kayjayB/I_cant_hear_you/Final Report/gainGUIAudiogram.PDF

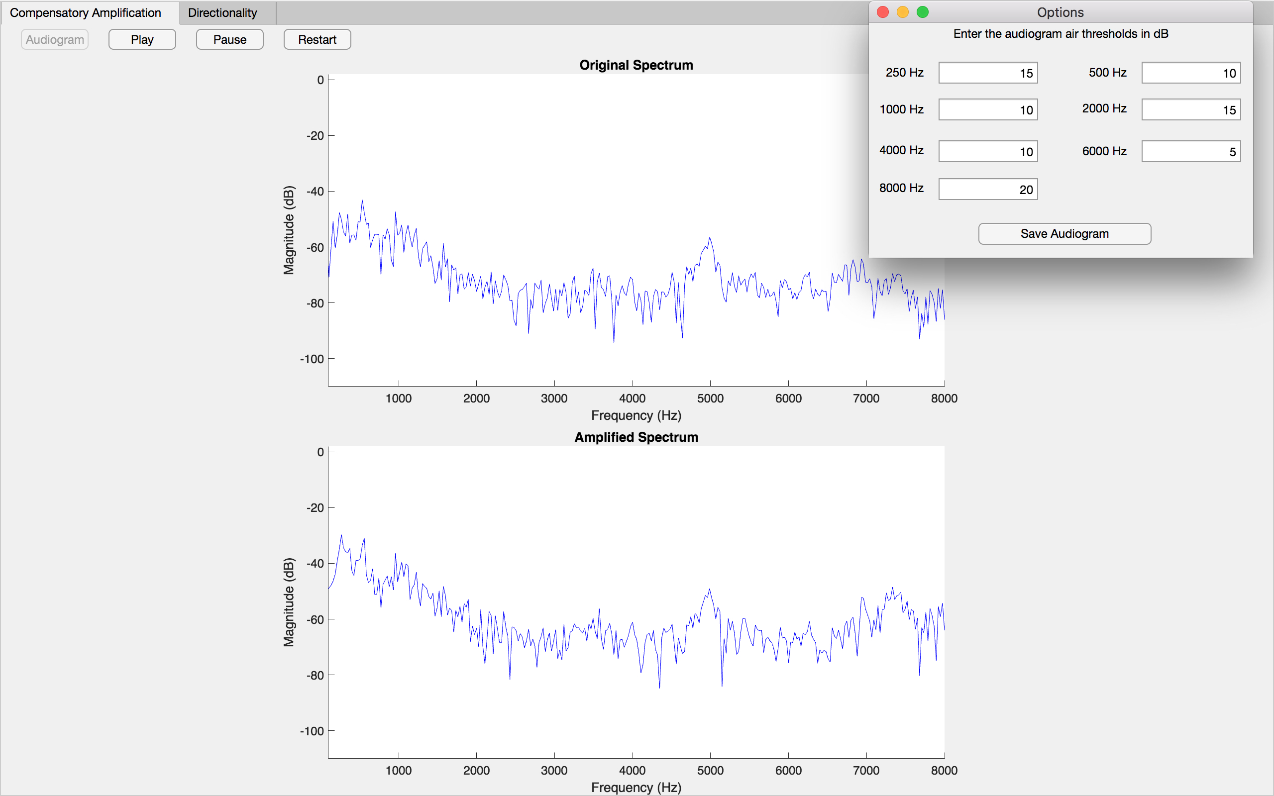
[picture p34: page 1]
