kayjayB/I_cant_hear_you/Final Report/dirGUI.PDF

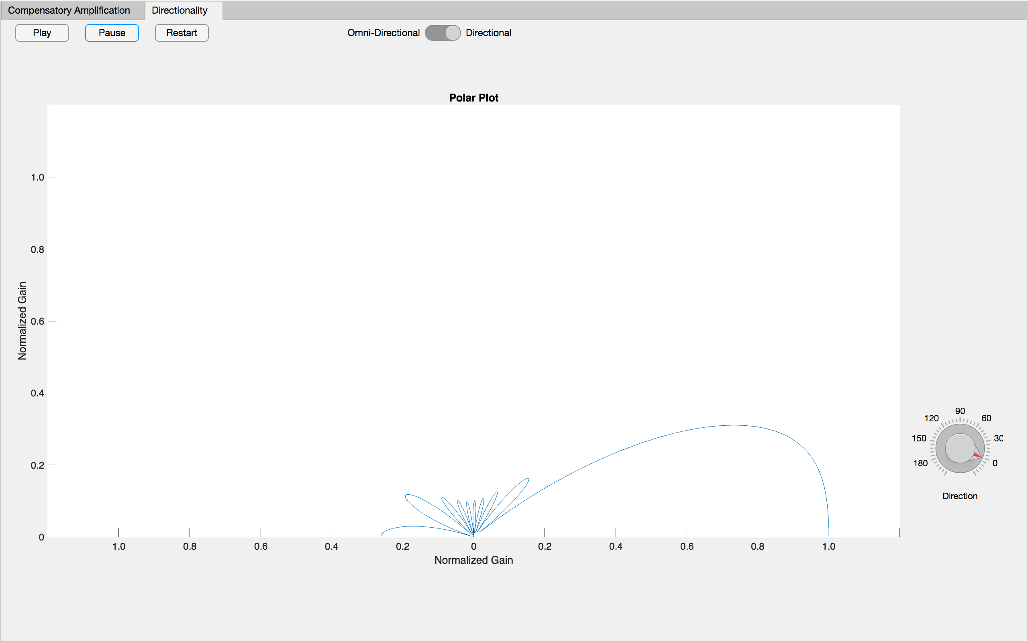
[picture p35: page 1]
