kayjayB/I_cant_hear_you/Final Report/dirGUISmall.PDF

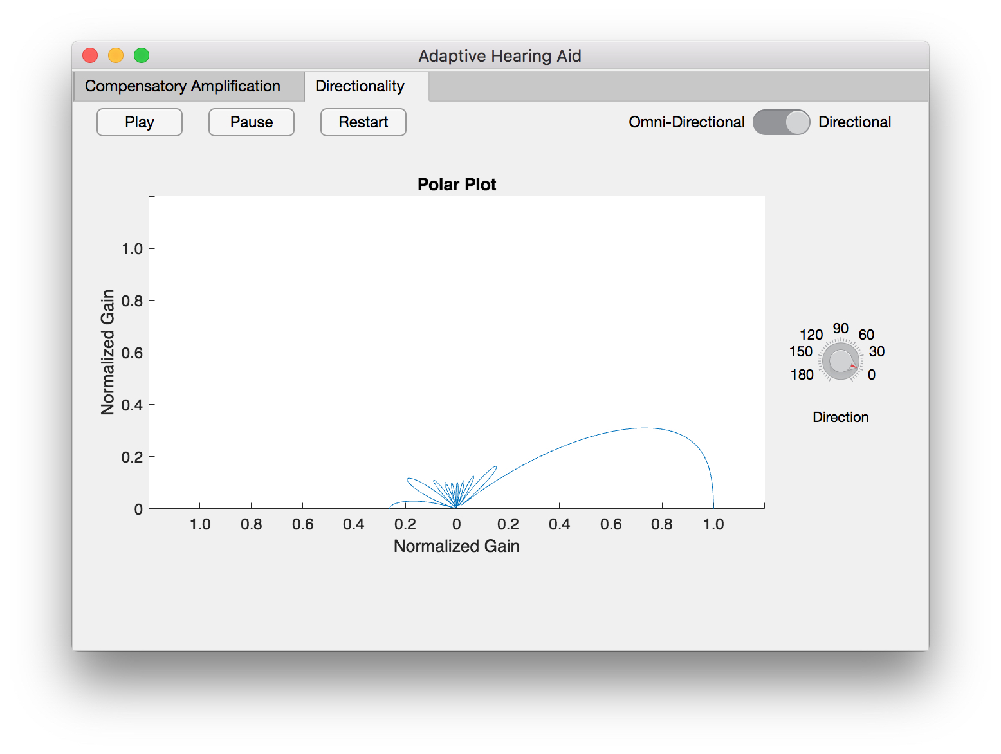
[picture p36: page 1]
