kayjayB/I_cant_hear_you/Final Report/gainGUI.PDF

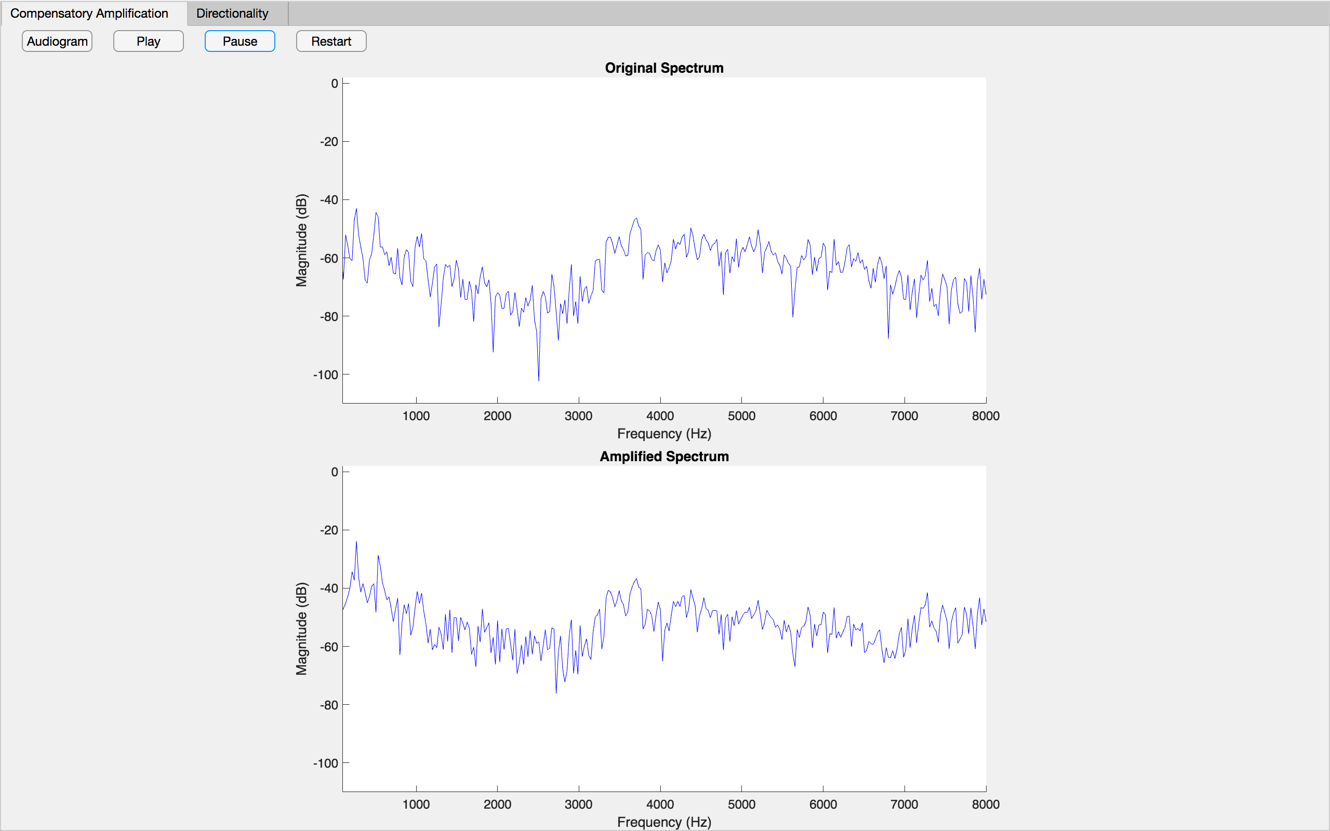
[picture p37: page 1]
