kayjayB/I_cant_hear_you/Final Report/gainGUISmall.PDF

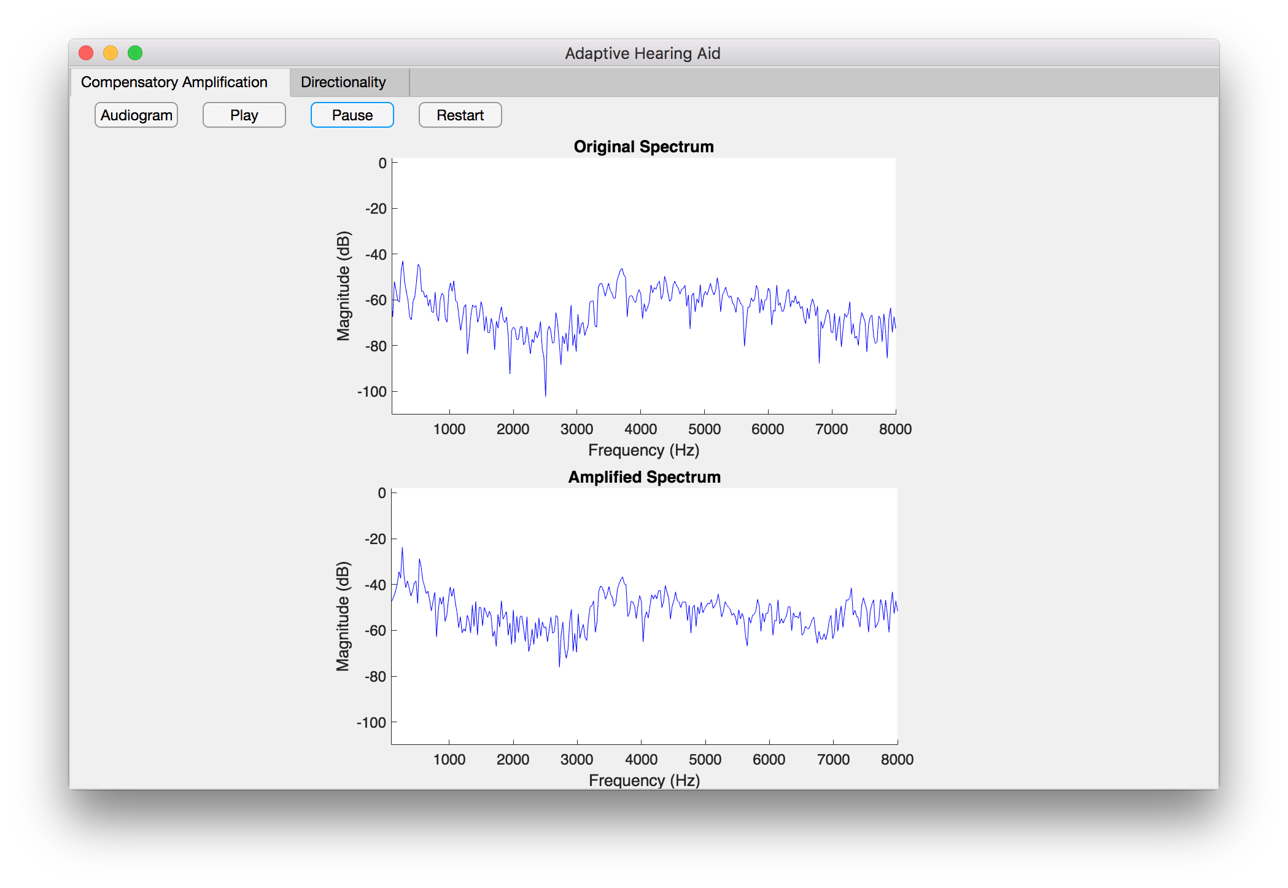
[picture p38: page 1]
