kayjayB/I_cant_hear_you/Poster/figures/EIE.pdf

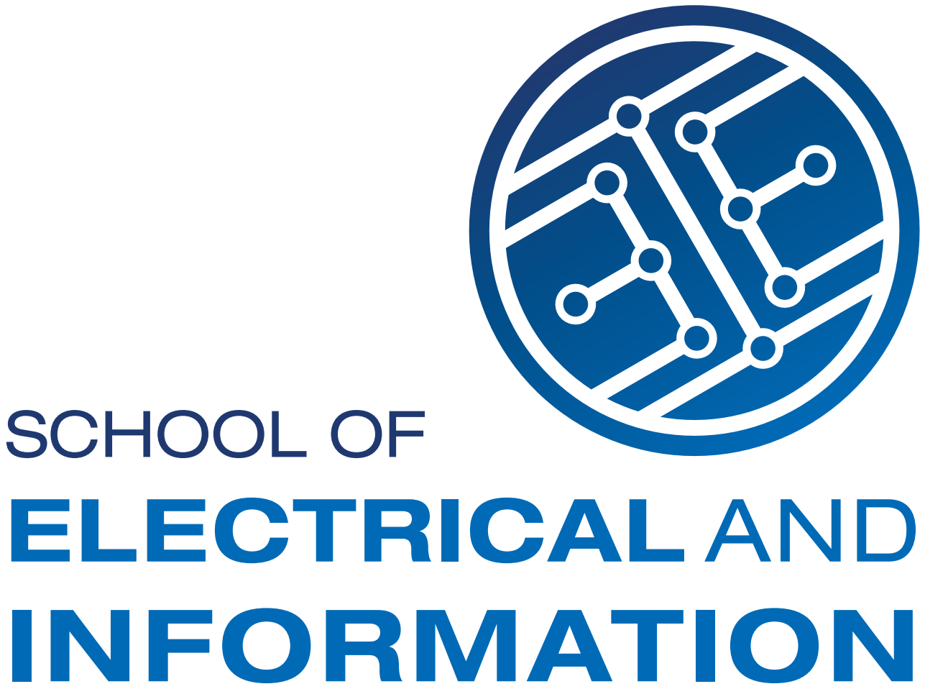
[picture p39: figure]
SCHOOL OF ELECTRICAL AND INFORMATION

ENGINEERING
