kayjayB/I_cant_hear_you/Final Report/analogFilterBank.png

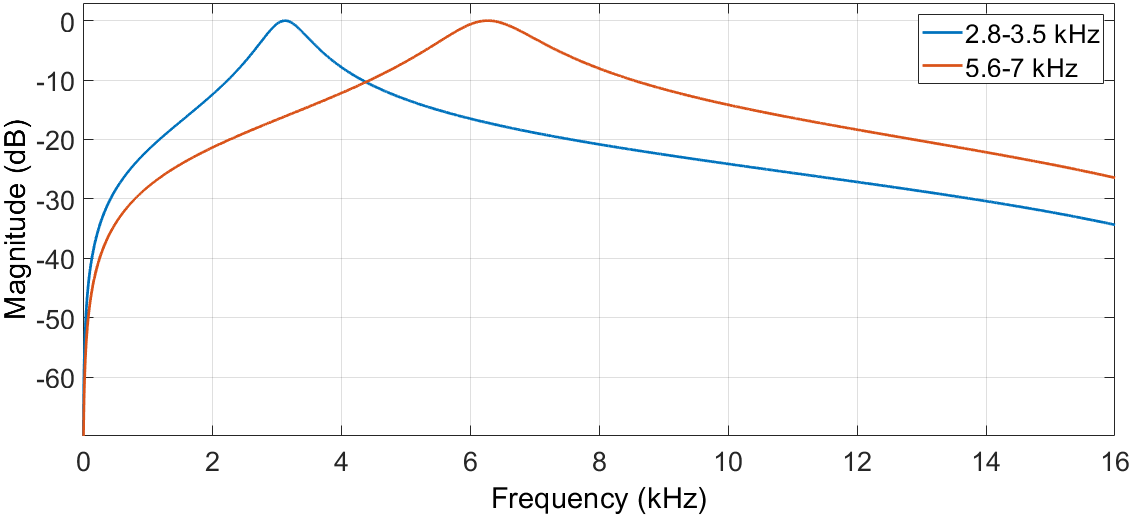
Final Report/analogFilterBank.png
