kayjayB/I_cant_hear_you/Final Report/audiogram.png

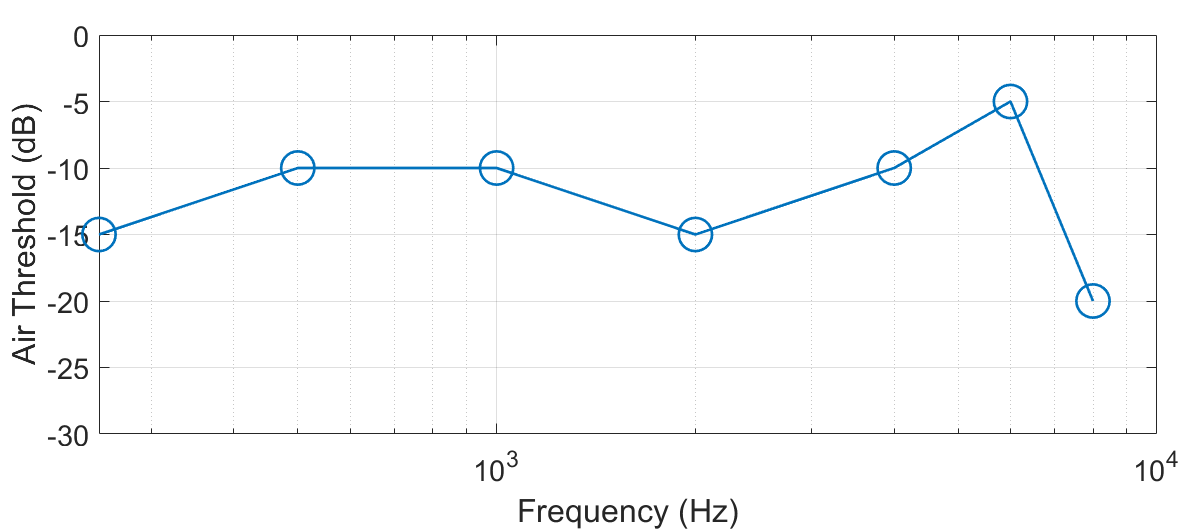
Final Report/audiogram.png
