kayjayB/I_cant_hear_you/Final Report/circuit3kband.png

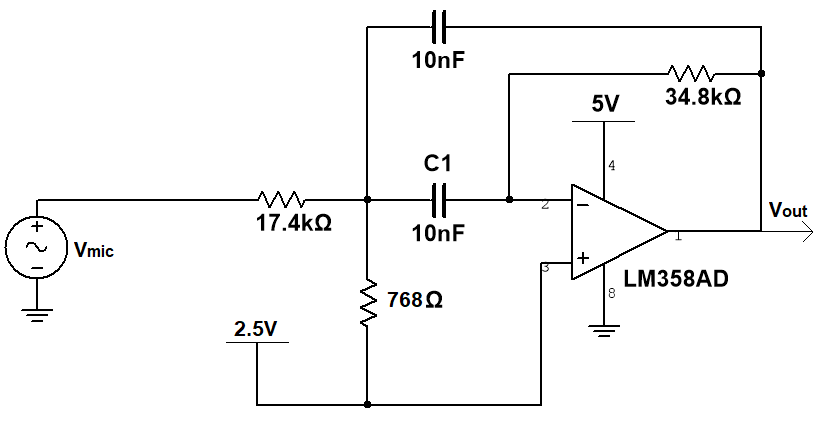
Final Report/circuit3kband.png
