kayjayB/I_cant_hear_you/Final Report/circuit6kband.png

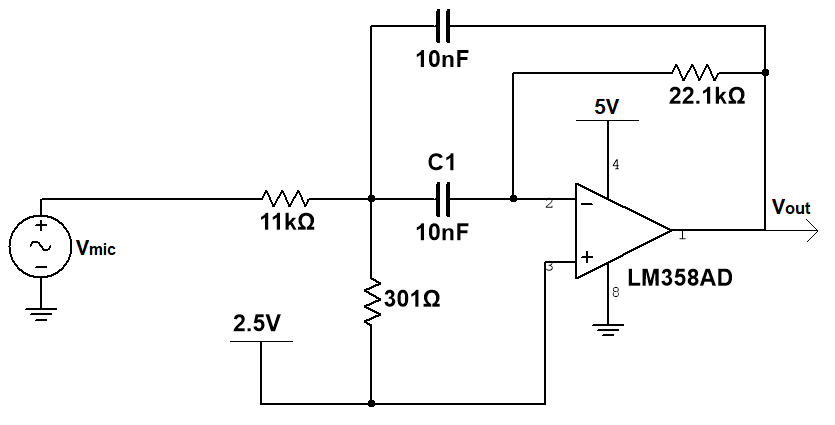
Final Report/circuit6kband.png
