kayjayB/I_cant_hear_you/Final Report/Dir0.png

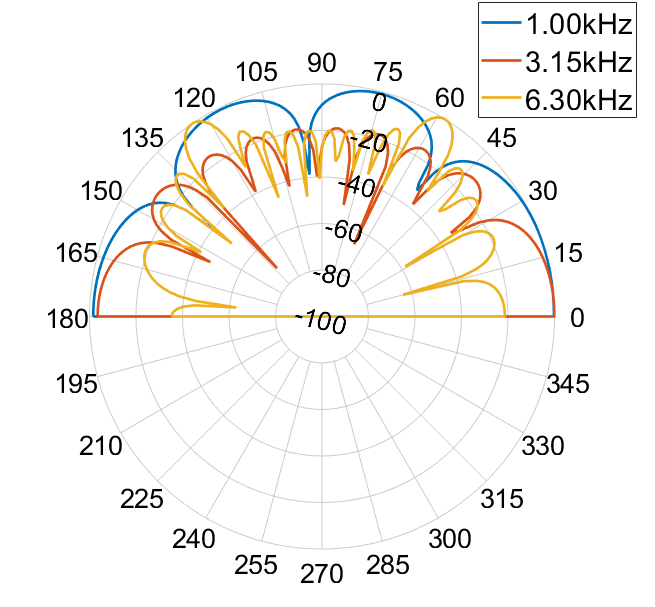
Final Report/Dir0.png
