kayjayB/I_cant_hear_you/Final Report/guiOmni.png

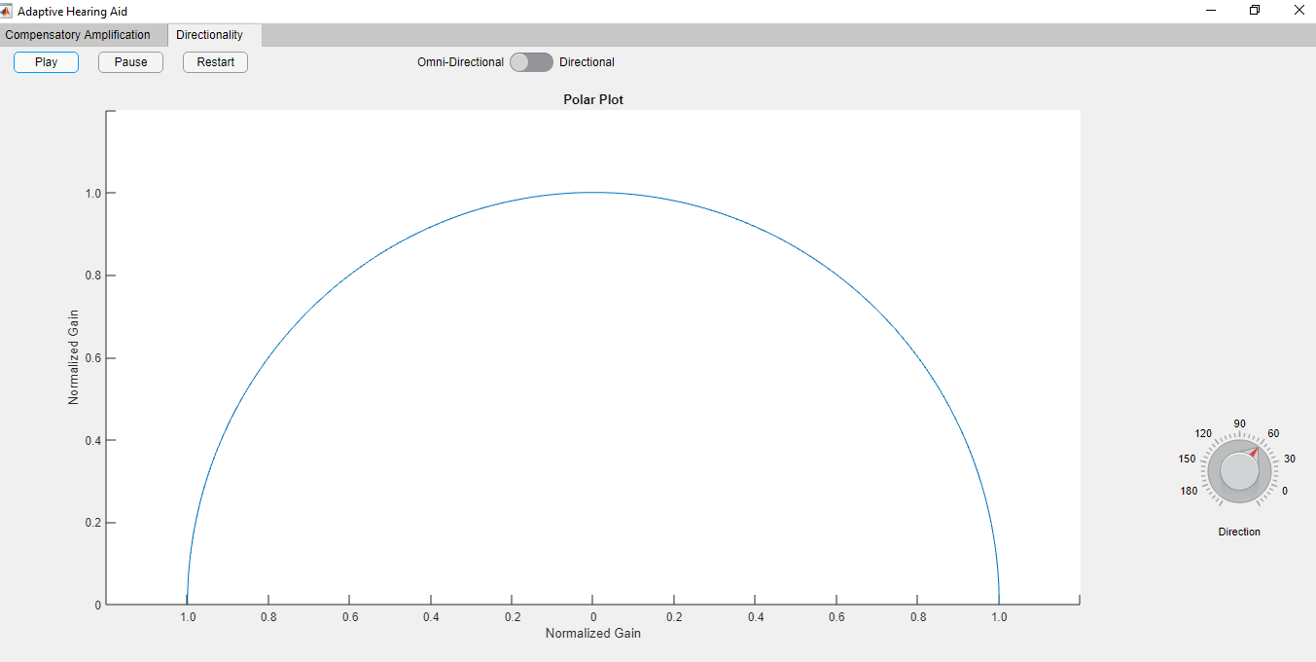
Final Report/guiOmni.png
