kayjayB/I_cant_hear_you/Final Report/guiPolar60.png

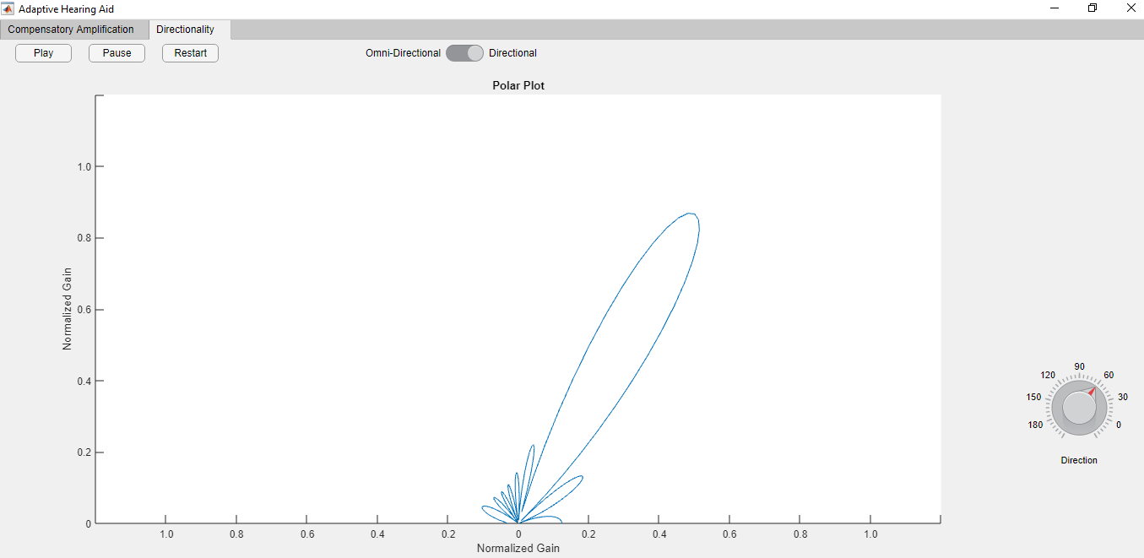
Final Report/guiPolar60.png
