kayjayB/I_cant_hear_you/Final Report/hardware0.png

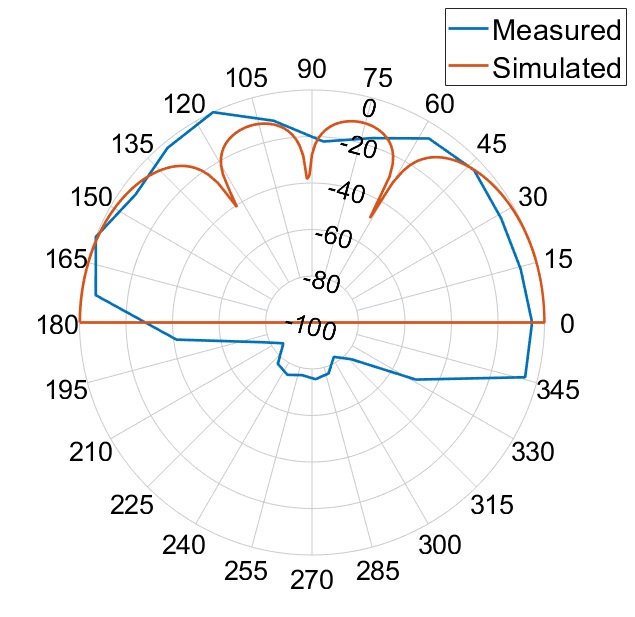
Final Report/hardware0.png
