kayjayB/I_cant_hear_you/Final Report/hardware120.png

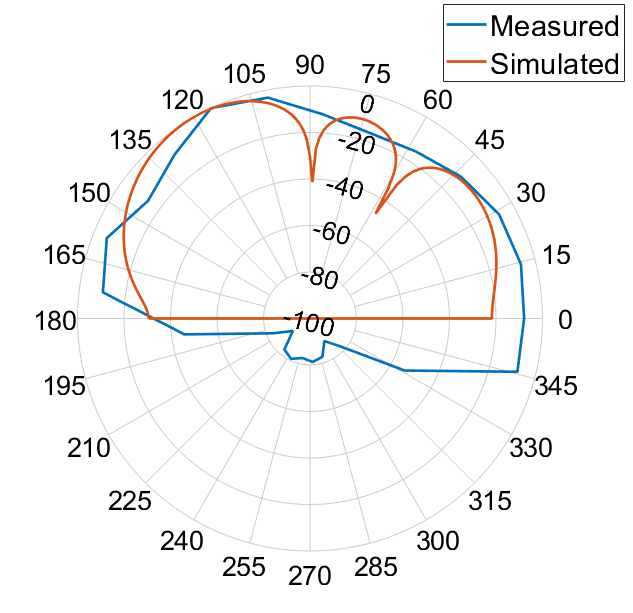
Final Report/hardware120.png
