kayjayB/I_cant_hear_you/Final Report/hardware180.png

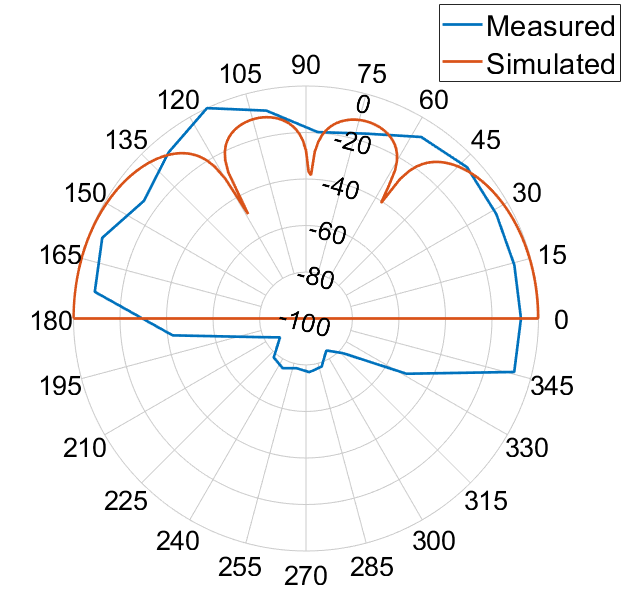
Final Report/hardware180.png
