kayjayB/I_cant_hear_you/Final Report/hardwareOmni.png

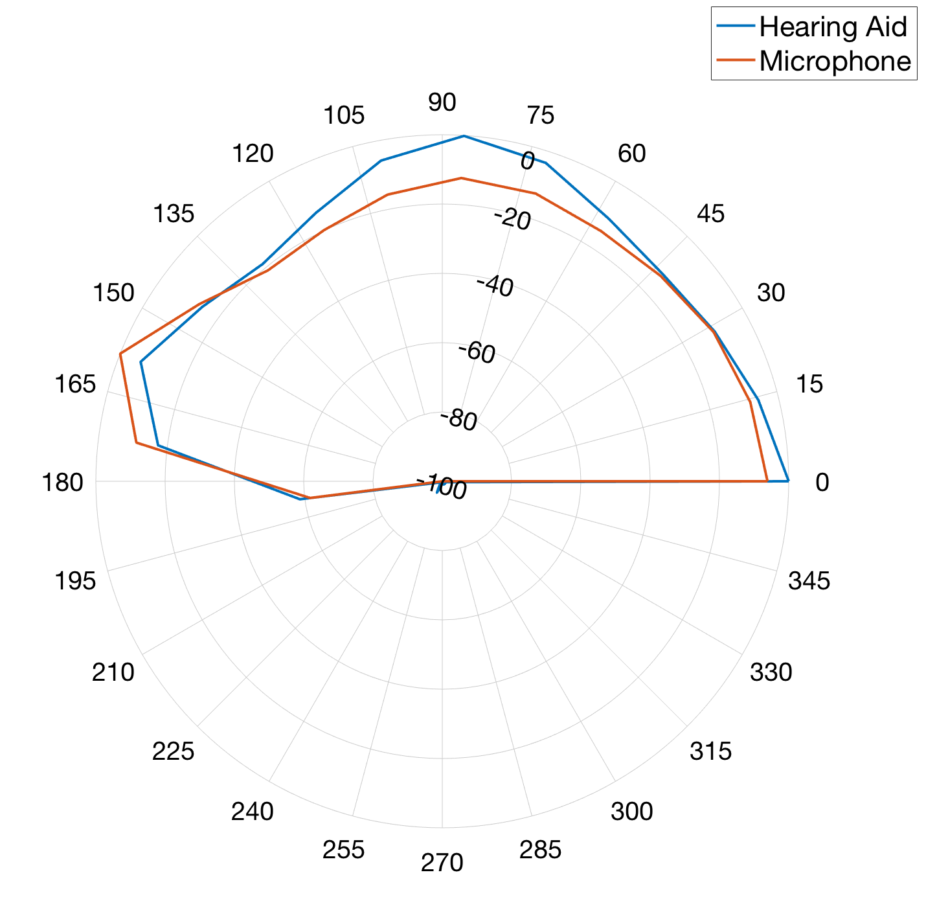
Final Report/hardwareOmni.png
