kayjayB/I_cant_hear_you/Final Report/posterBlockDiagram.png

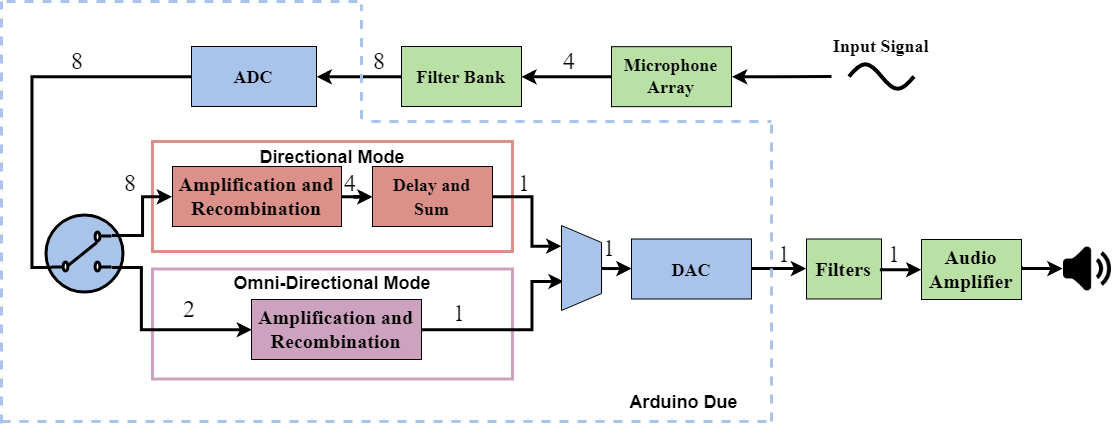
Final Report/posterBlockDiagram.png
