kayjayB/I_cant_hear_you/Memes/0ce60ced1e4ded8629fa3b05bb8c4171--hipster-humor-hipster-dog.jpg

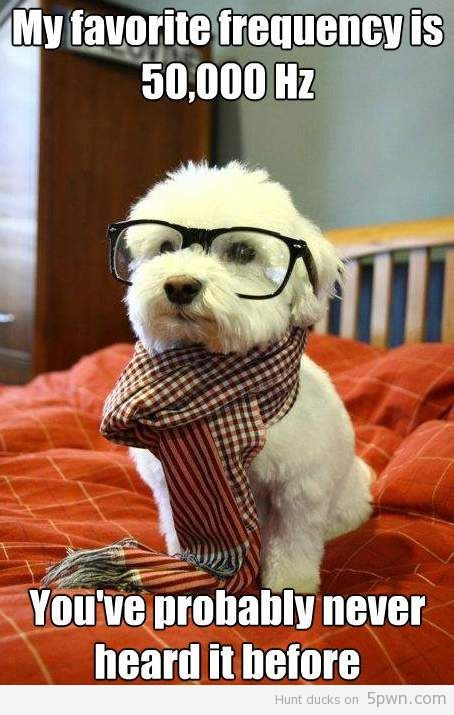
Memes/0ce60ced1e4ded8629fa3b05bb8c4171--hipster-humor-hipster-dog.jpg
