kayjayB/I_cant_hear_you/Memes/cat ignore.jpg

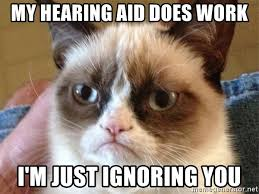
Memes/cat ignore.jpg
