kayjayB/I_cant_hear_you/Memes/pretend not to hear.jpg

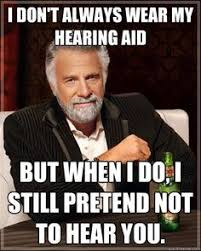
Memes/pretend not to hear.jpg
