kayjayB/I_cant_hear_you/Poster/figures/audiogram.png

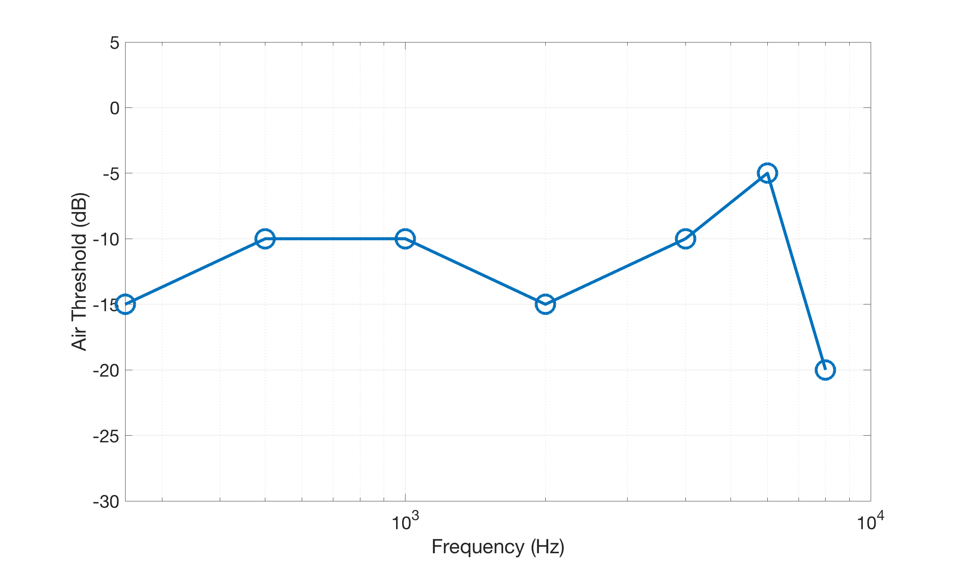
Poster/figures/audiogram.png
