kayjayB/I_cant_hear_you/Poster/figures/cartesian.png

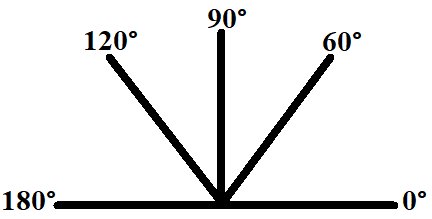
Poster/figures/cartesian.png
