kayjayB/I_cant_hear_you/Poster/figures/deg0hardware.png

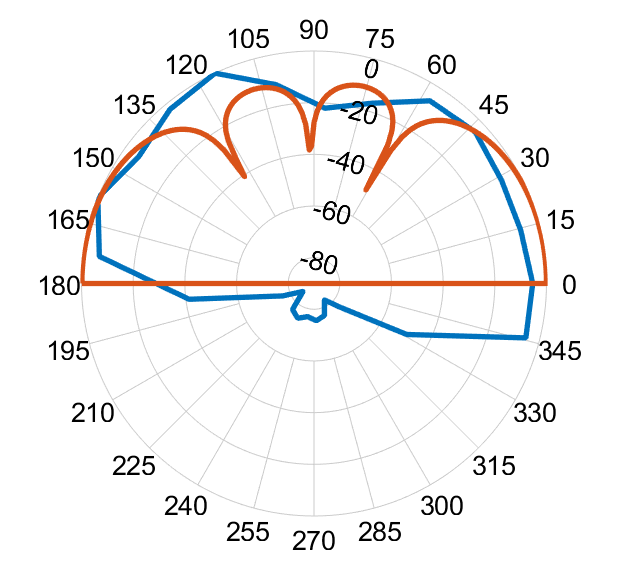
Poster/figures/deg0hardware.png
