kayjayB/I_cant_hear_you/Poster/figures/deg60hardware.png

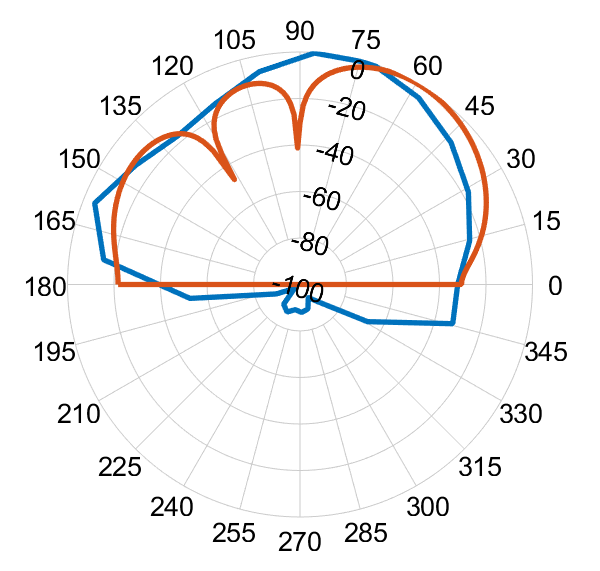
Poster/figures/deg60hardware.png
