kayjayB/I_cant_hear_you/Poster/figures/deg120hardware.png

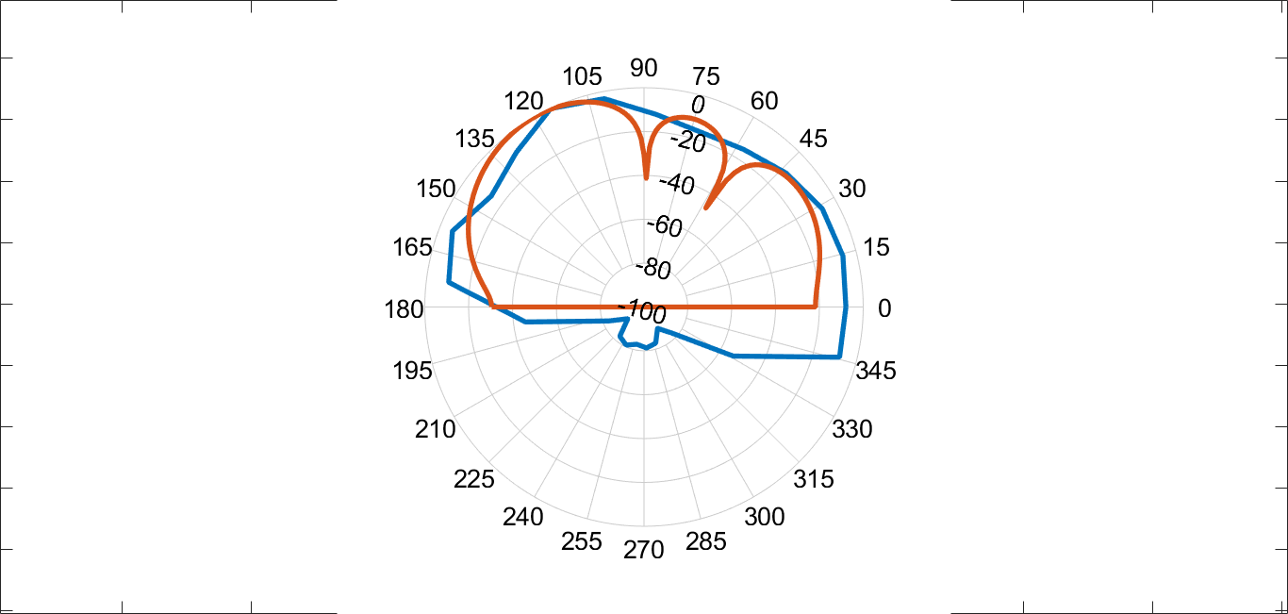
Poster/figures/deg120hardware.png
