kayjayB/I_cant_hear_you/Poster/figures/dirErrorBarGraph.png

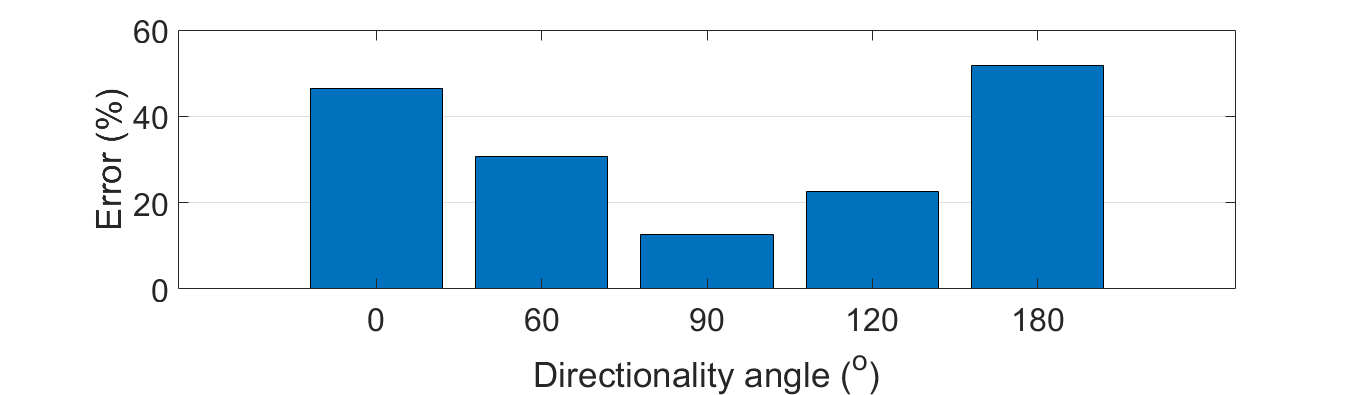
Poster/figures/dirErrorBarGraph.png
