kayjayB/I_cant_hear_you/Poster/figures/dirErrorPlot.png

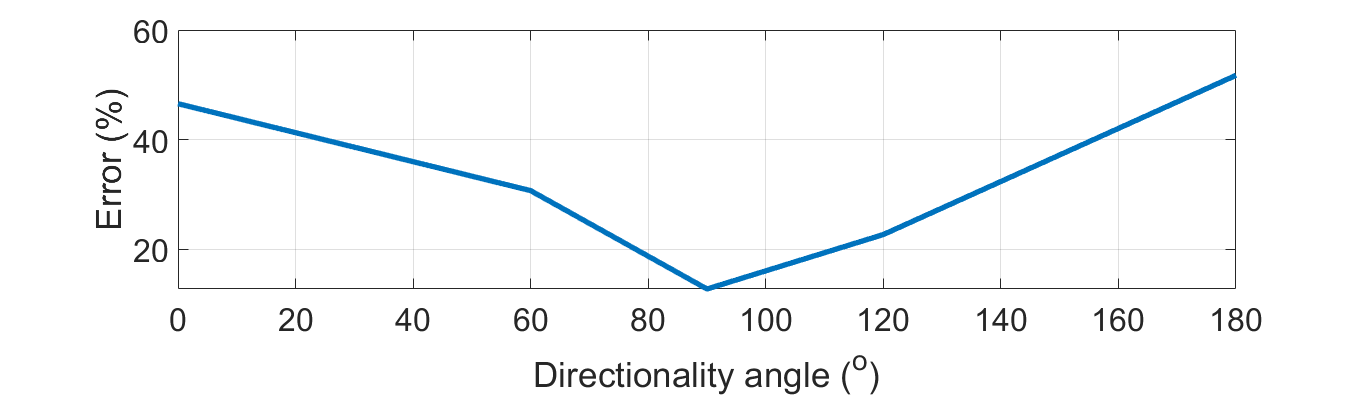
Poster/figures/dirErrorPlot.png
