kayjayB/I_cant_hear_you/Poster/figures/fftSoftwareBold.png

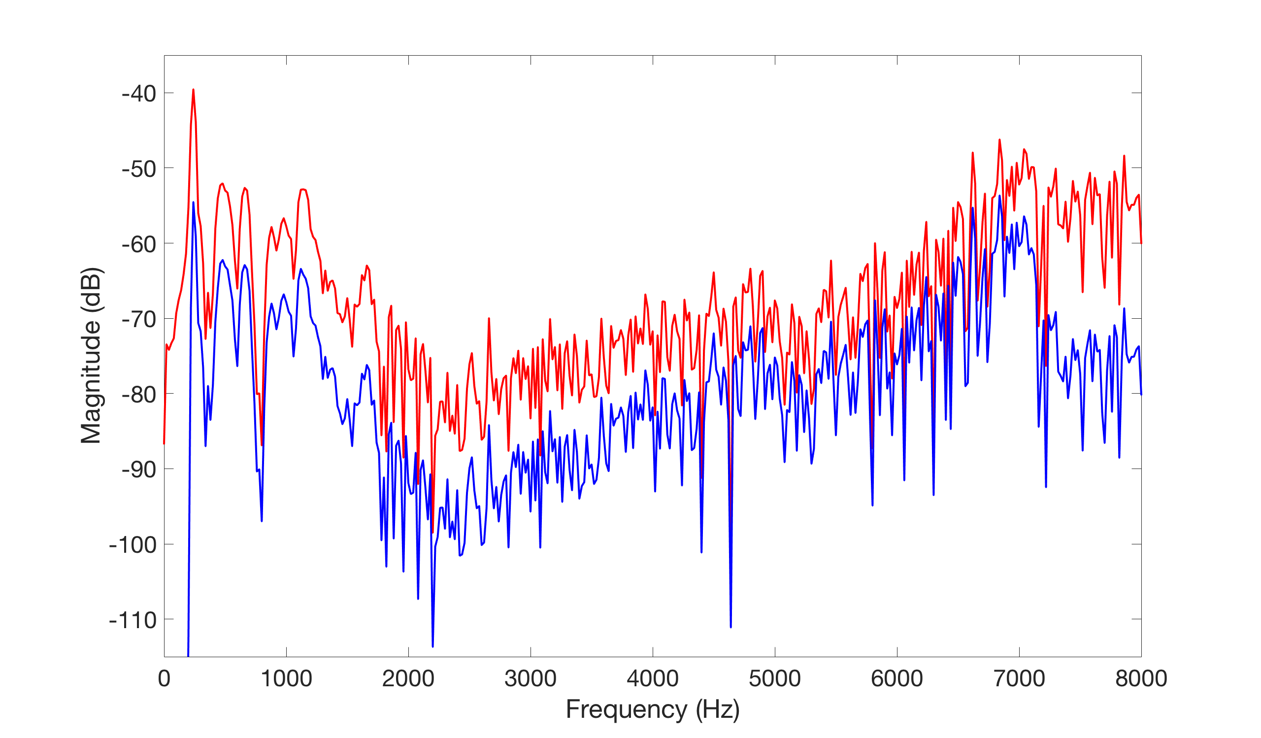
Poster/figures/fftSoftwareBold.png
