kayjayB/I_cant_hear_you/Planning Report/directionalityClinicalTest.png

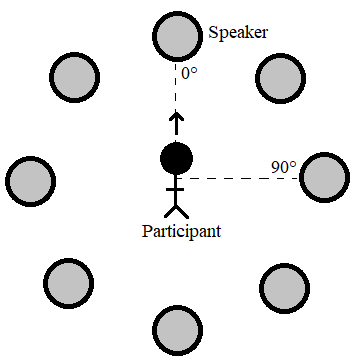
Planning Report/directionalityClinicalTest.png
