kayjayB/I_cant_hear_you/Final Report/posterBlockDiagram.pdf

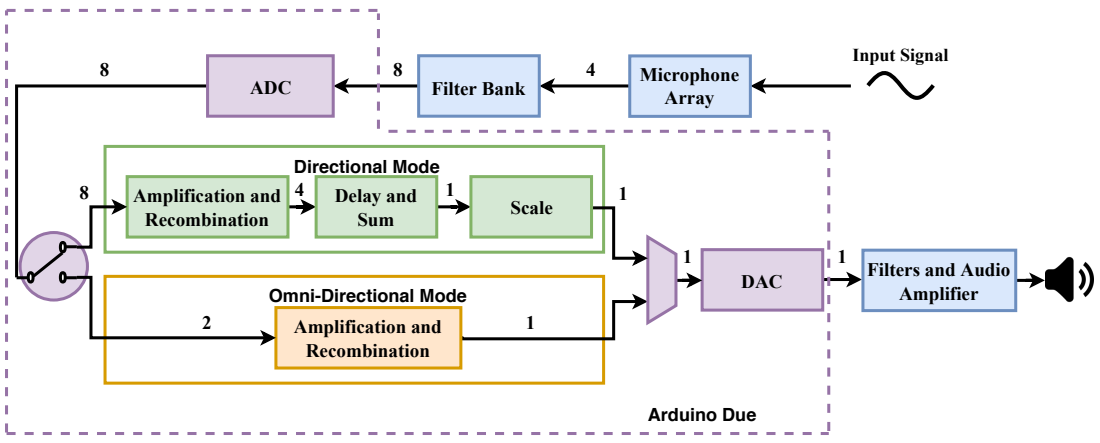
[picture p64: page 1]
Microphone; Array ADC; Filter Bank; Amplification and Recombination; Delay and Sum; DAC; Input Signal; Directional Mode; Arduino Due; Scale

Filters and Audio
Amplifier

Omni-Directional Mode
Amplification and
Recombination
