kayjayB/I_cant_hear_you/Poster/figures/posterBlockDiagram.pdf

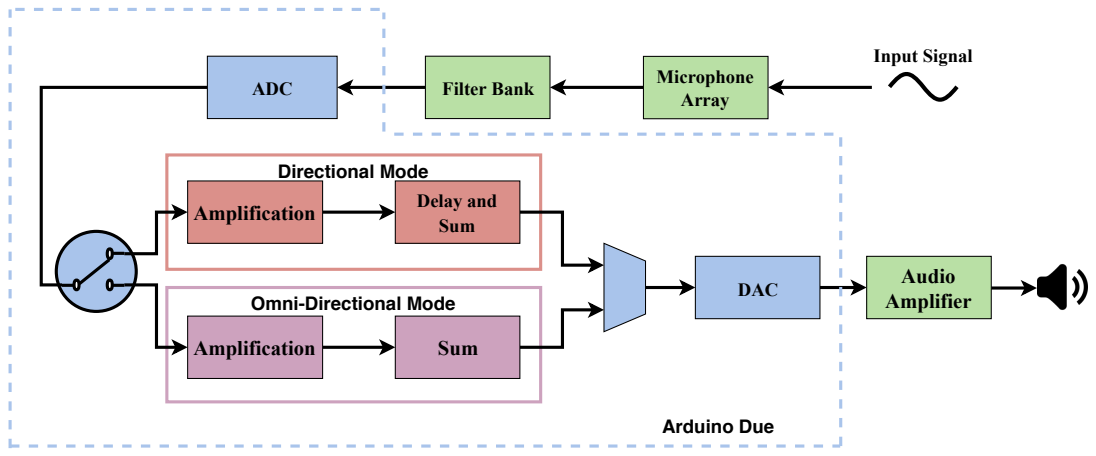
[picture p65: page 1]
Microphone; Array ADC; Filter Bank; Amplification; Delay and; Sum; DAC; Input Signal; Audio Amplifier; Directional Mode; Arduino Due

Omni-Directional Mode
