kayjayB/I_cant_hear_you/Presentation/18G04 P42 Presentation.pdf

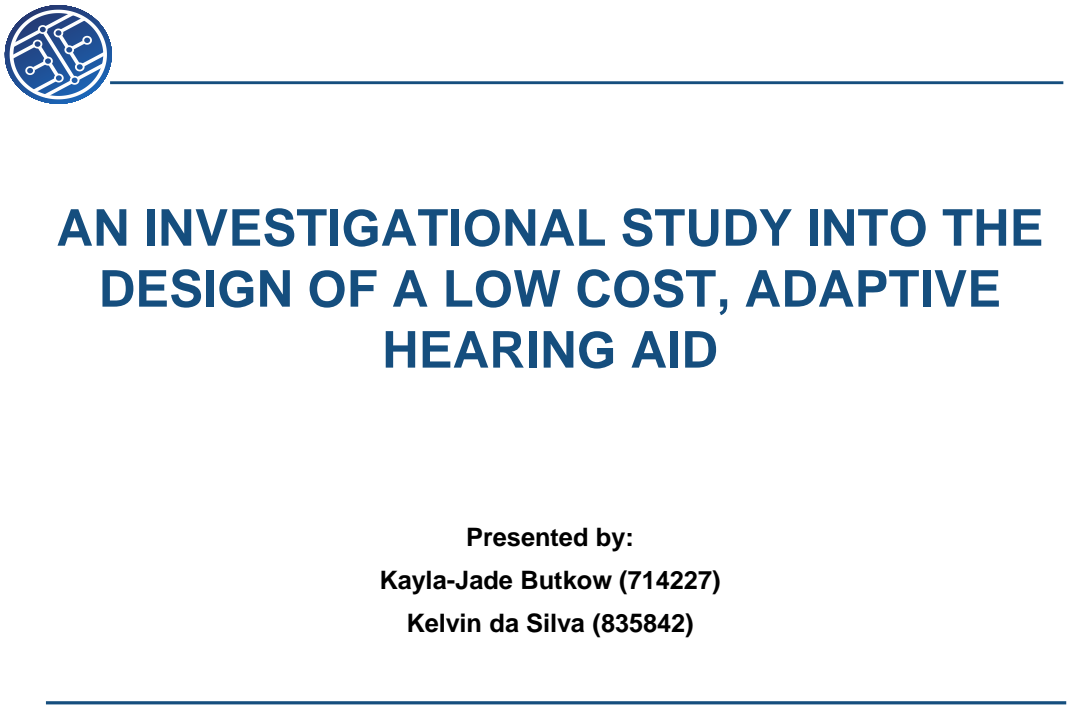
[picture p66: page 1]
HEARING AID; Presented by:

AN INVESTIGATIONAL STUDY INTO THE
DESIGN OF A LOW COST, ADAPTIVE

Kayla-Jade Butkow (714227)
Kelvin da Silva (835842)

## Outline

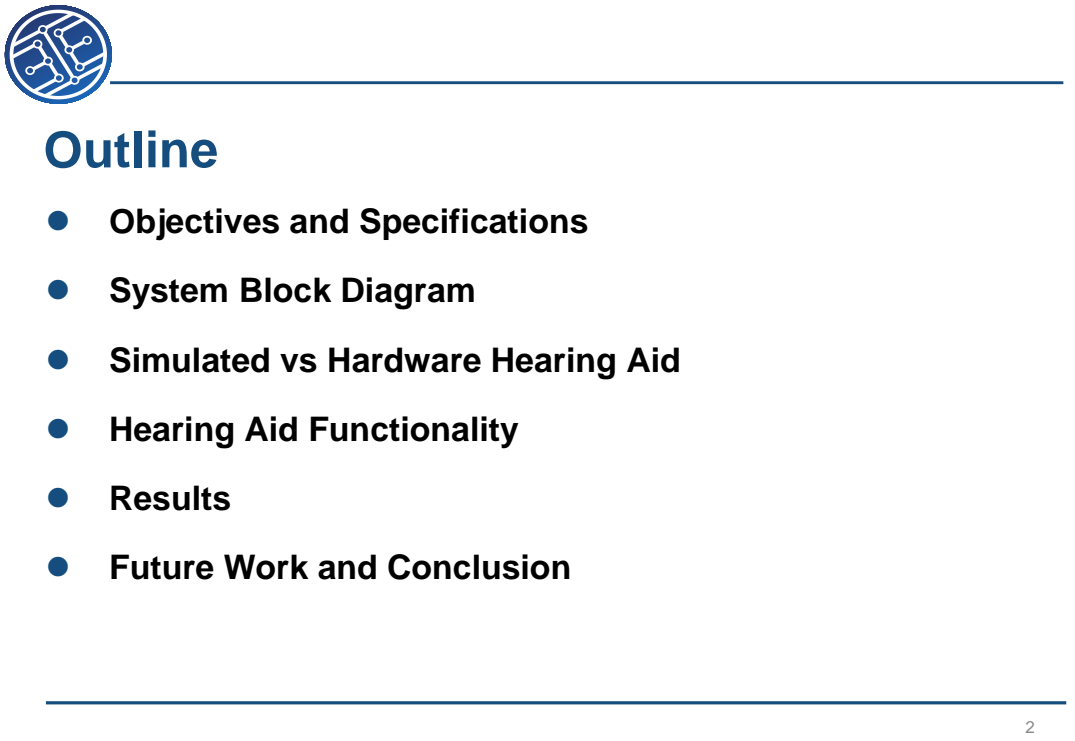
[picture p67: page 2]
● Results

● Objectives and Specifications

● System Block Diagram

● Simulated vs Hardware Hearing Aid

● Hearing Aid Functionality

● Future Work and Conclusion

## Objectives and Specifications

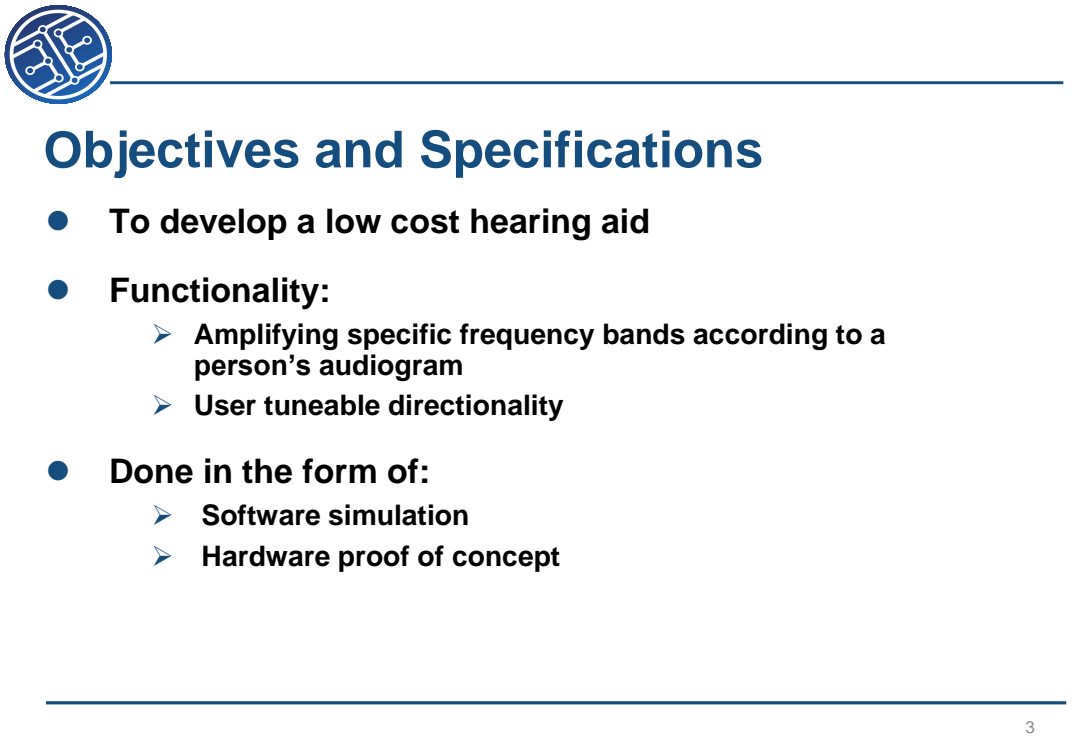
[picture p68: page 3]
● Functionality:

● To develop a low cost hearing aid

Amplifying specific frequency bands according to a
person’s audiogram
User tuneable directionality

● Done in the form of:

Software simulation
Hardware proof of concept

## System Block Diagram

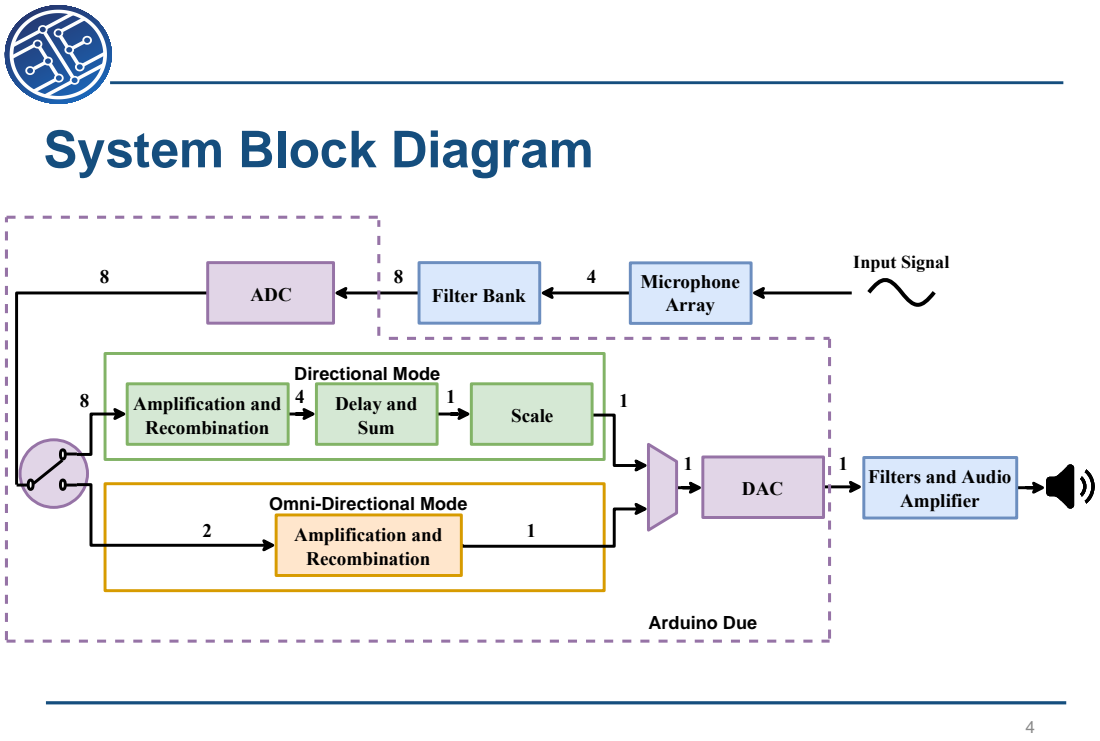
[picture p69: page 4]
Microphone Array; ADC; Filter Bank; Amplification and Recombination; Delay and Sum; DAC; Input Signal; Directional Mode; Arduino Due; Scale

Filters and Audio
Amplifier

Omni-Directional Mode
Amplification and
Recombination

## Simulated vs Hardware Hearing Aid

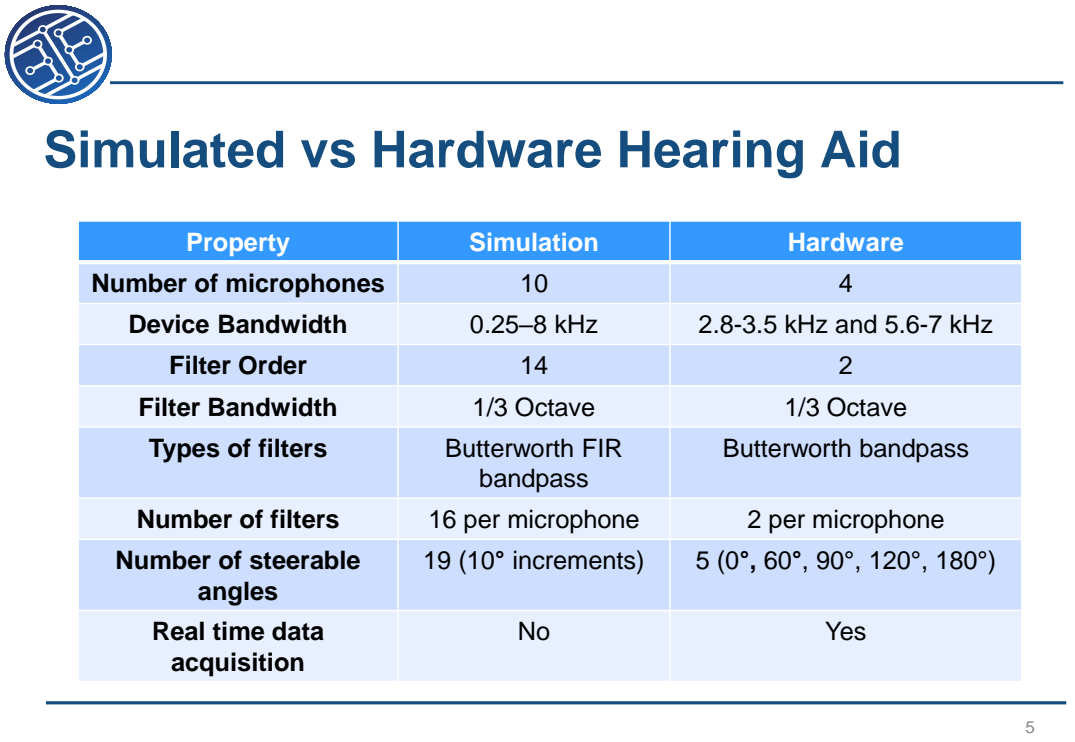
[picture p70: page 5]

Property | Simulation | Hardware

Number of microphones | 10 | 4
Device Bandwidth | 0.25–8 kHz | 2.8-3.5 kHz and 5.6-7 kHz
Filter Order | 14 | 2
Filter Bandwidth | 1/3 Octave | 1/3 Octave
Types of filters | Butterworth FIR bandpass | Butterworth bandpass

Number of filters | 16 per microphone | 2 per microphone
Number of steerable angles | 19 (10° increments) | 5 (0° , 60°, 90°, 120°, 180°)

Real time data acquisition | No | Yes

## Compensatory Amplification

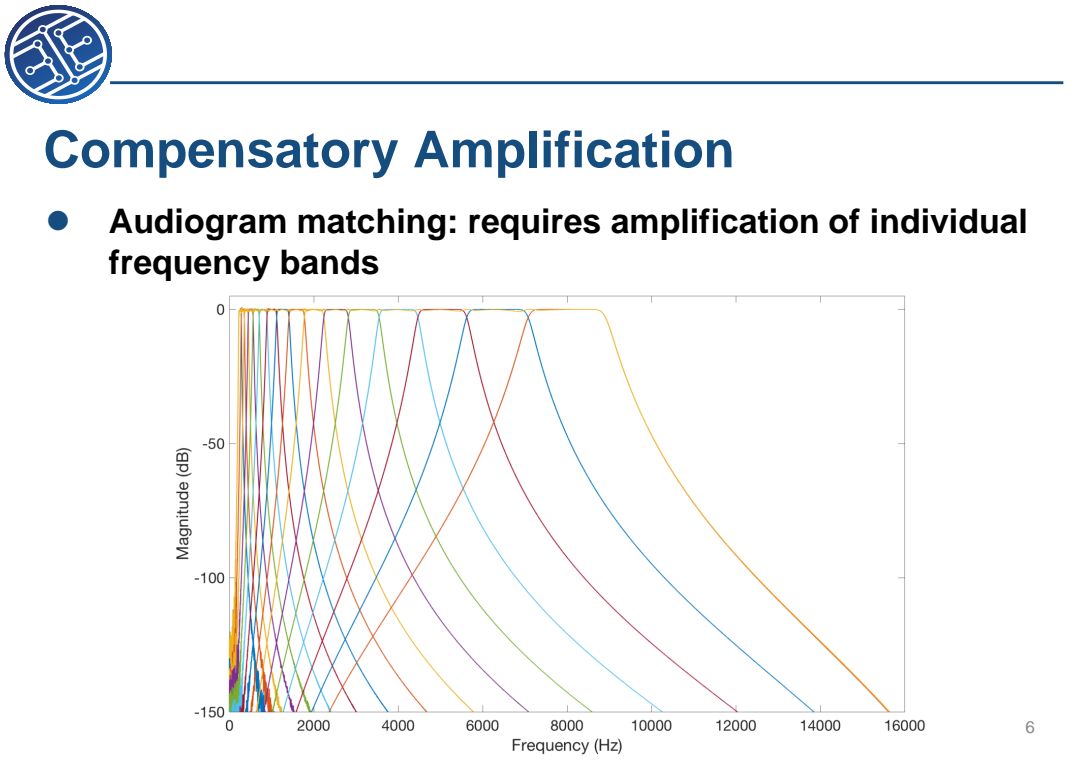
[picture p71: page 6]

● Audiogram matching: requires amplification of individual
frequency bands

## Directionality

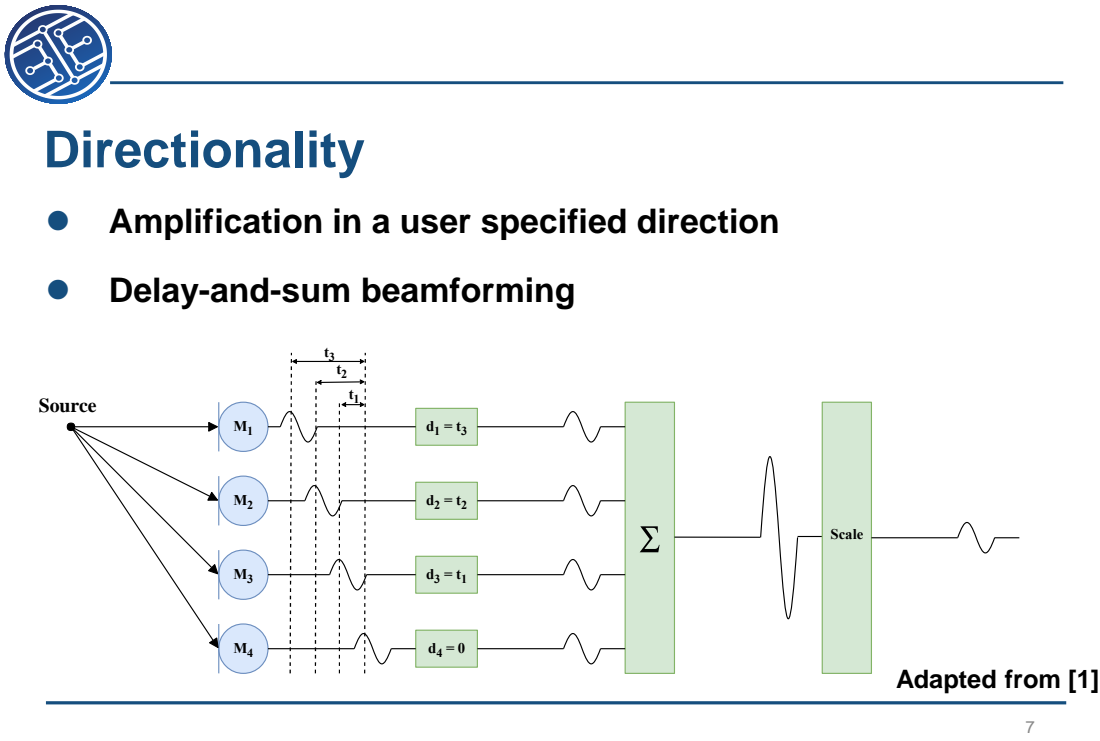
[picture p72: page 7]
Scale; Adapted from [1]; Source

● Amplification in a user specified direction

● Delay-and-sum beamforming

## Testing

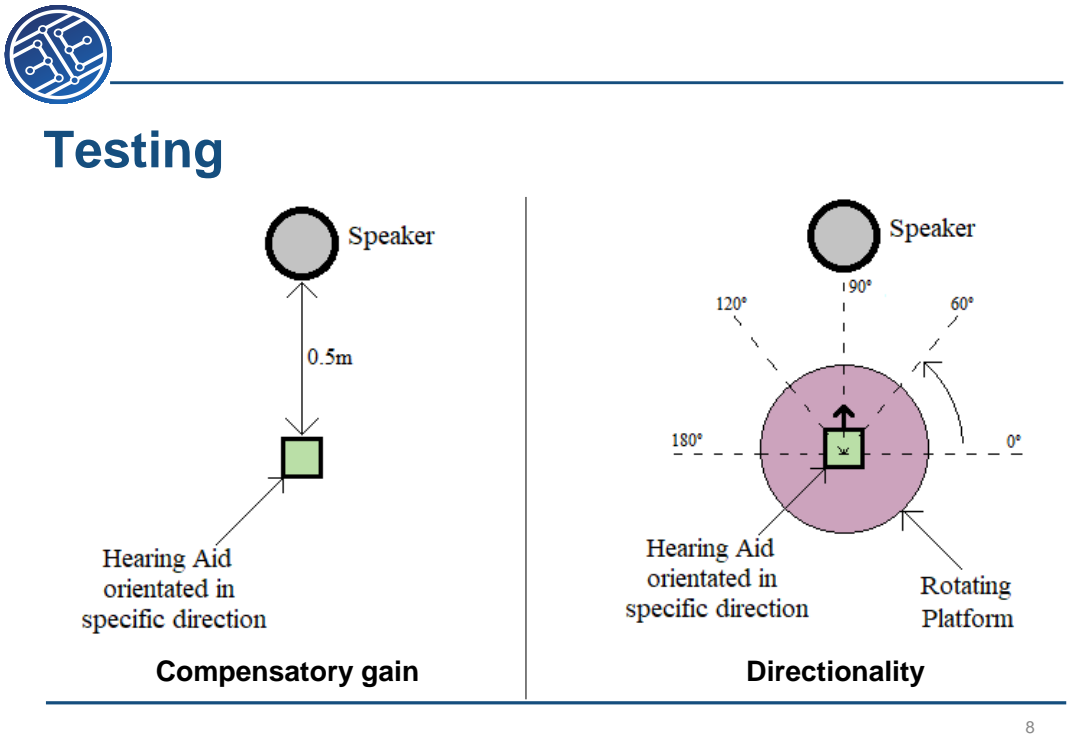
[picture p73: page 8]
Compensatory gain; Directionality

## Simulation Results: Amplification

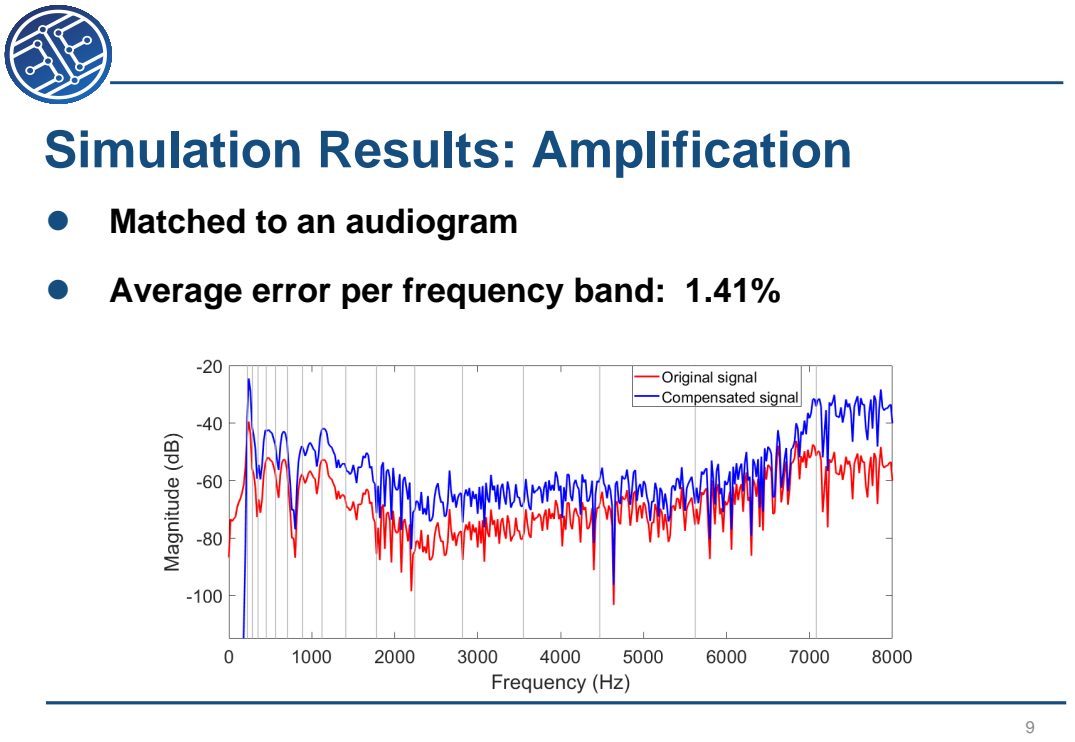
[picture p74: page 9]

● Matched to an audiogram

● Average error per frequency band: 1.41%

## Simulation Results: Directionality

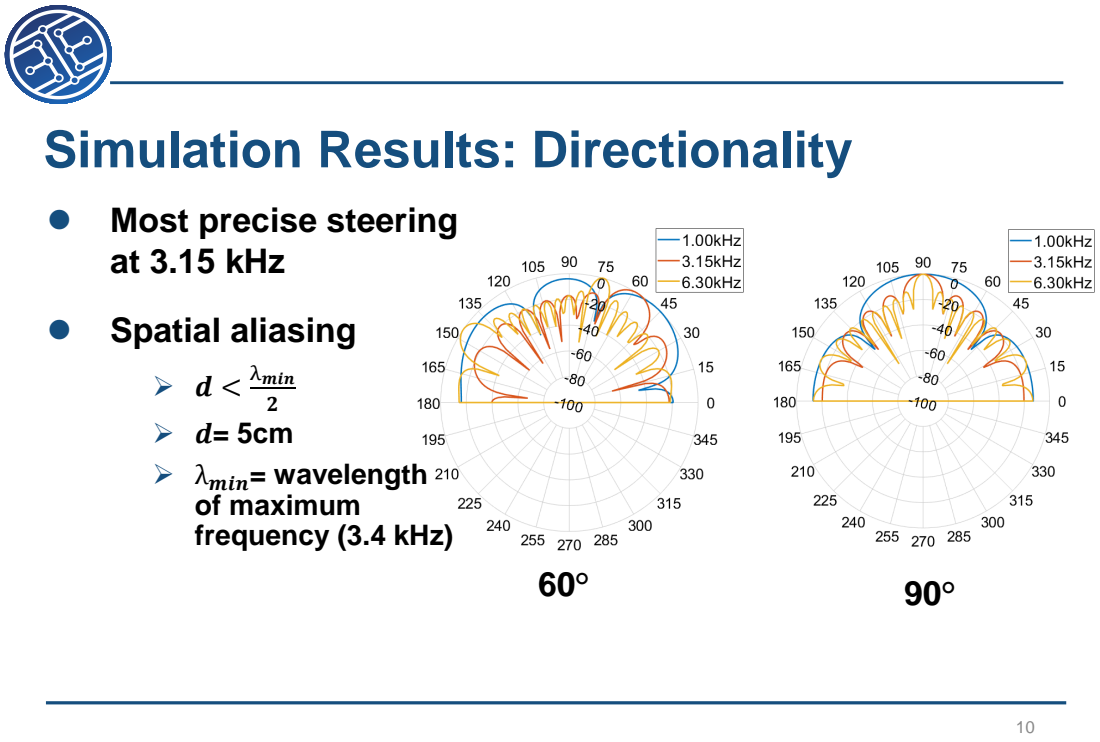
[picture p75: page 10]
● Spatial aliasing; λmin; λmin= wavelength of maximum frequency (3.4 kHz)

● Most precise steering
at 3.15 kHz

## Hardware Results: Amplification

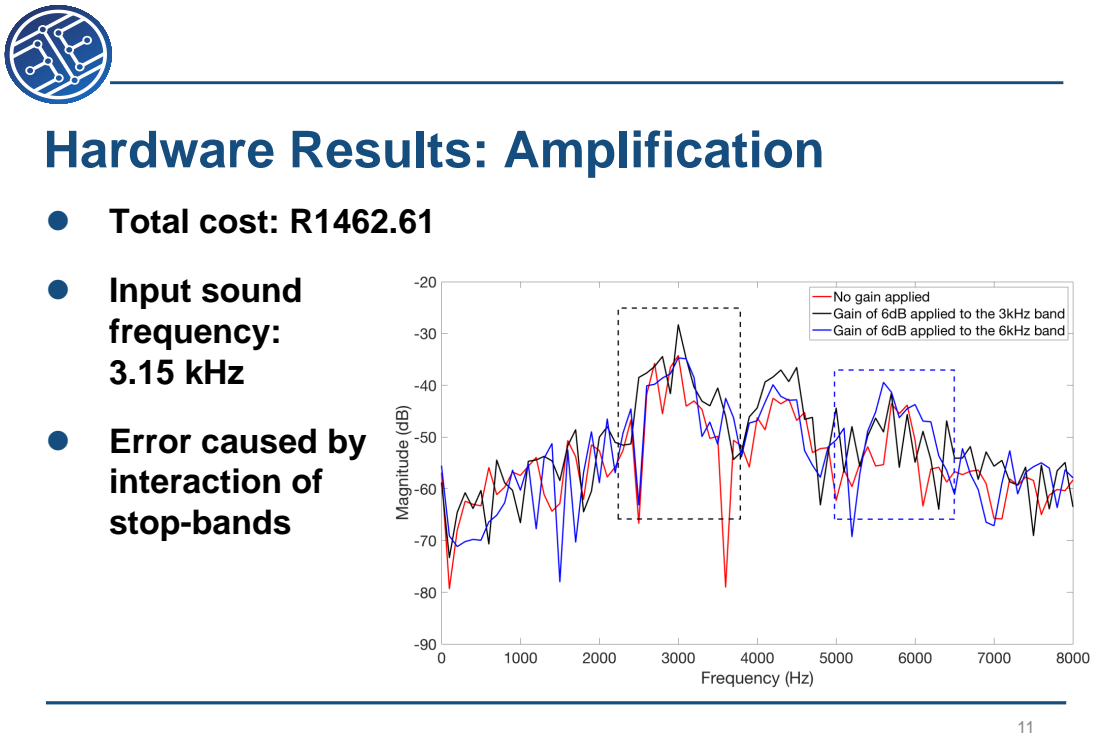
[picture p76: page 11]
● Total cost: R1462.61; ● Input sound frequency: 3.15 kHz

● Error caused by
interaction of
stop-bands

## Hardware Results: Directionality

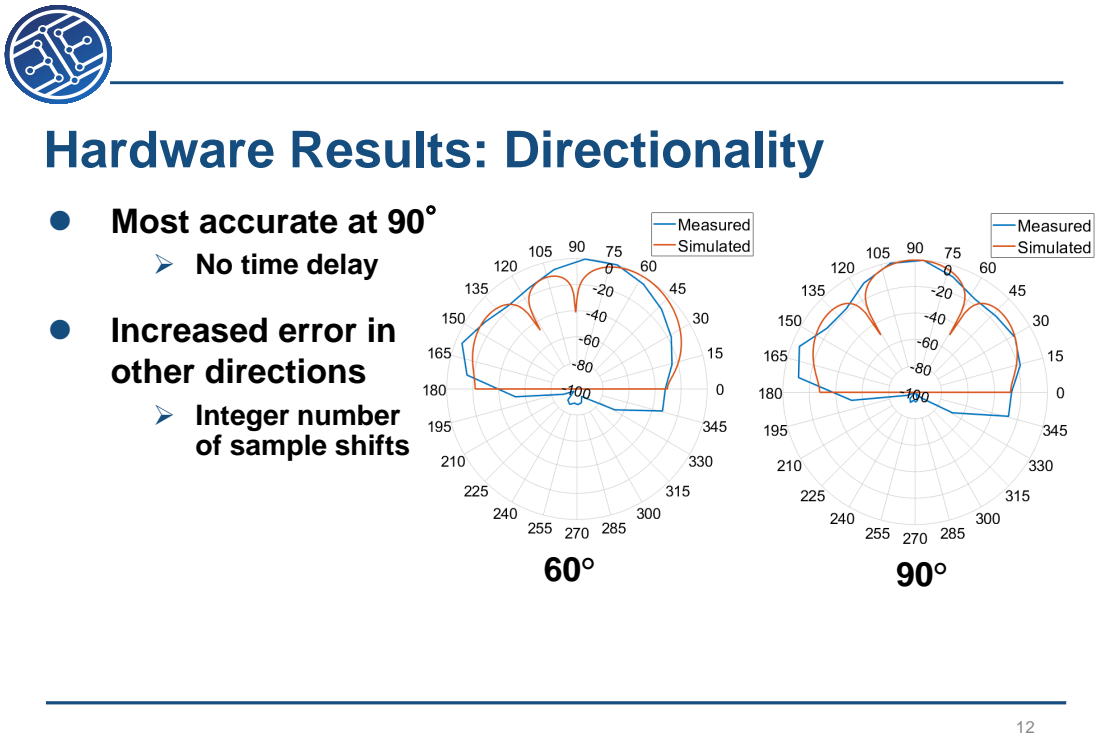
[picture p77: page 12]

● Most accurate at 90°

No time delay

● Increased error in
other directions
Integer number
of sample shifts

## System Error Analysis

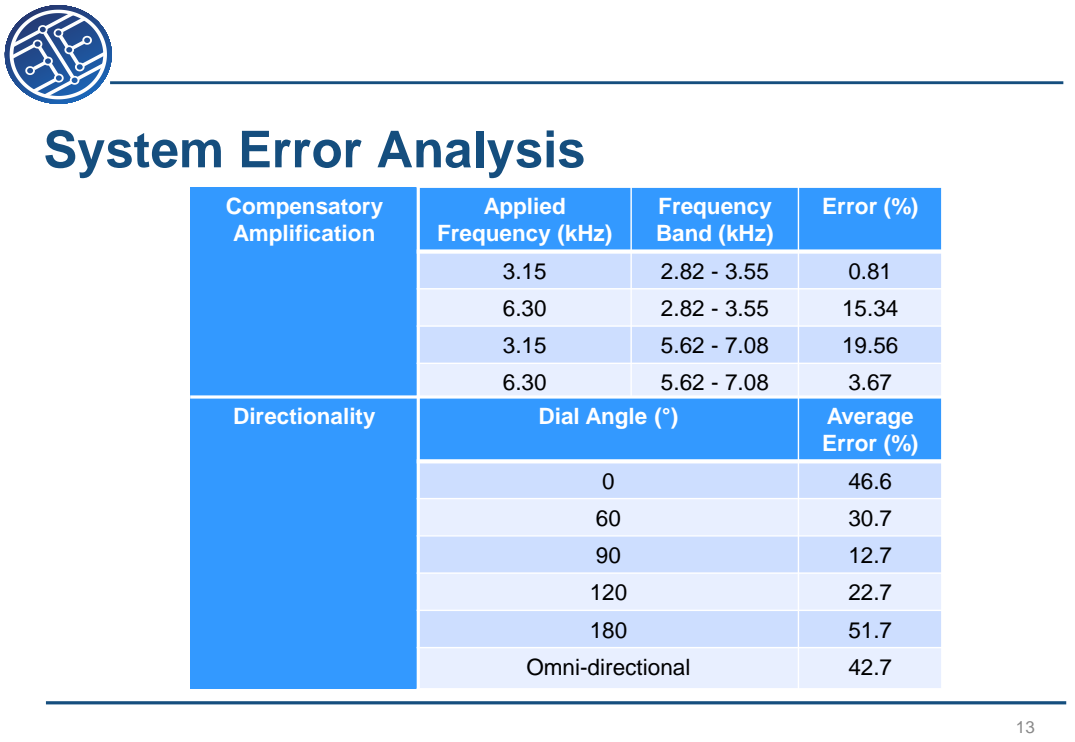
[picture p78: page 13]
Compensatory Amplification; Directionality; Dial Angle (°); Average

Applied Frequency (kHz) | Frequency Band (kHz) | Error (%)

3.15 | 2.82 - 3.55 | 0.81
6.30 | 2.82 - 3.55 | 15.34
3.15 | 5.62 - 7.08 | 19.56
6.30 | 5.62 - 7.08 | 3.67

Error (%)

0 | | 46.6
60 | | 30.7
90 | | 12.7
120 | | 22.7
180 | | 51.7
Omni-directional | | 42.7

## Future Work

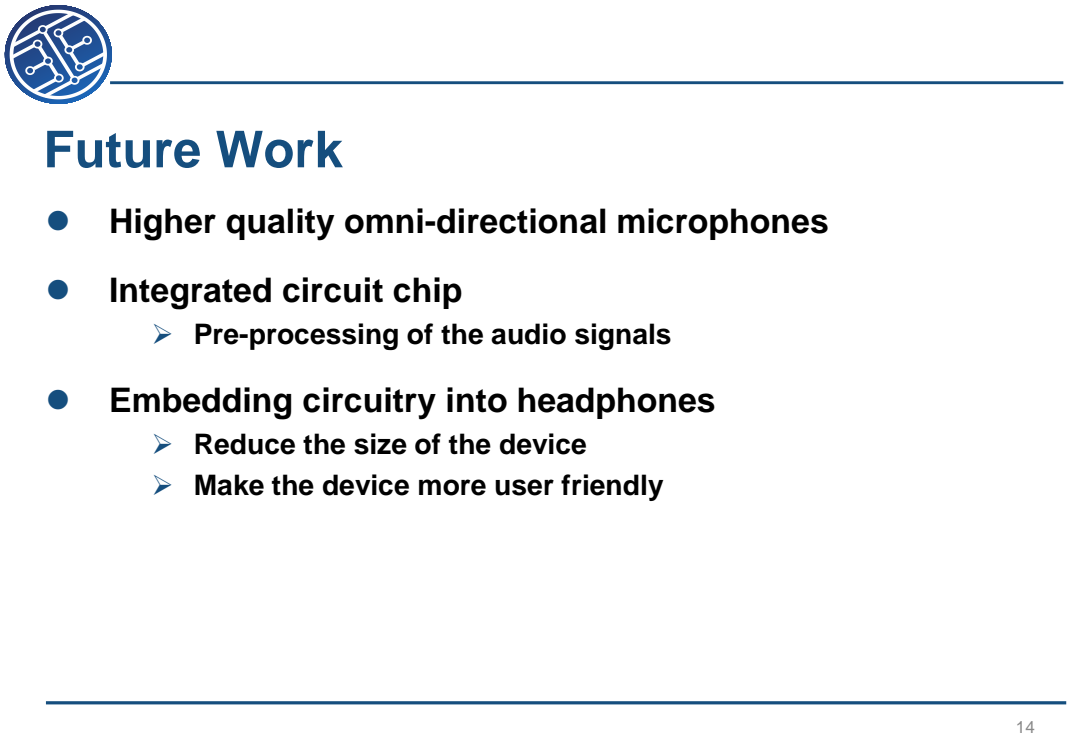
[picture p79: page 14]

● Higher quality omni-directional microphones

● Integrated circuit chip

Pre-processing of the audio signals

● Embedding circuitry into headphones

Reduce the size of the device
Make the device more user friendly

## Conclusion

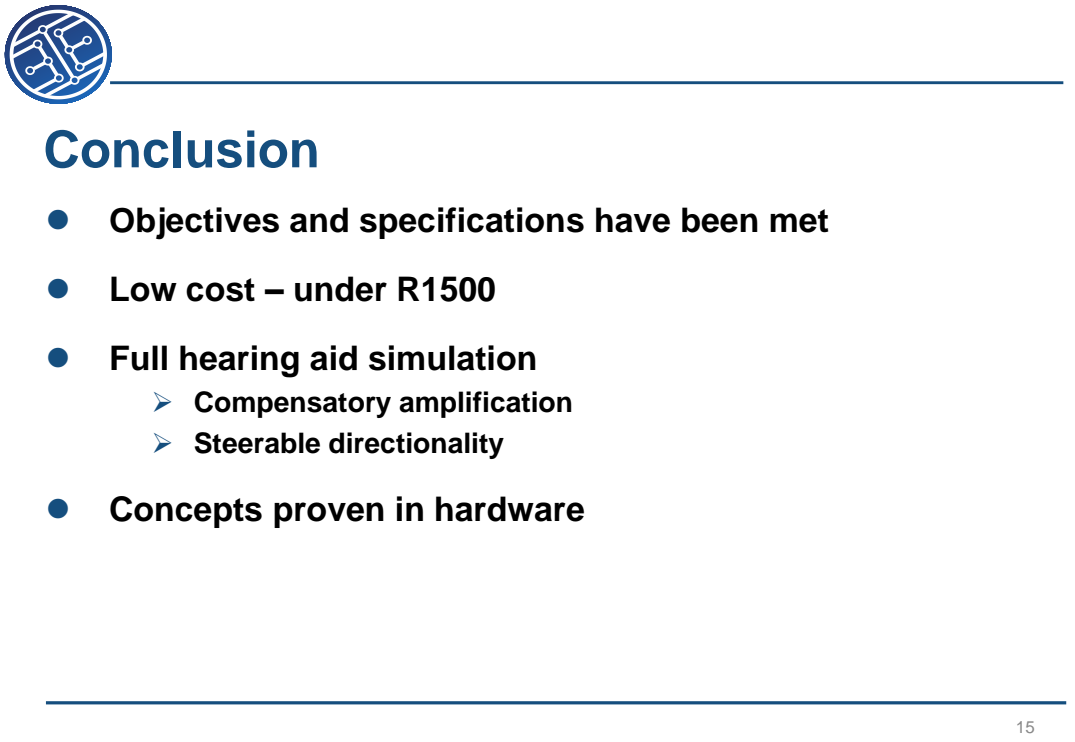
[picture p80: page 15]
Compensatory amplification; Steerable directionality

● Objectives and specifications have been met

● Low cost – under R1500

● Full hearing aid simulation

● Concepts proven in hardware

## References

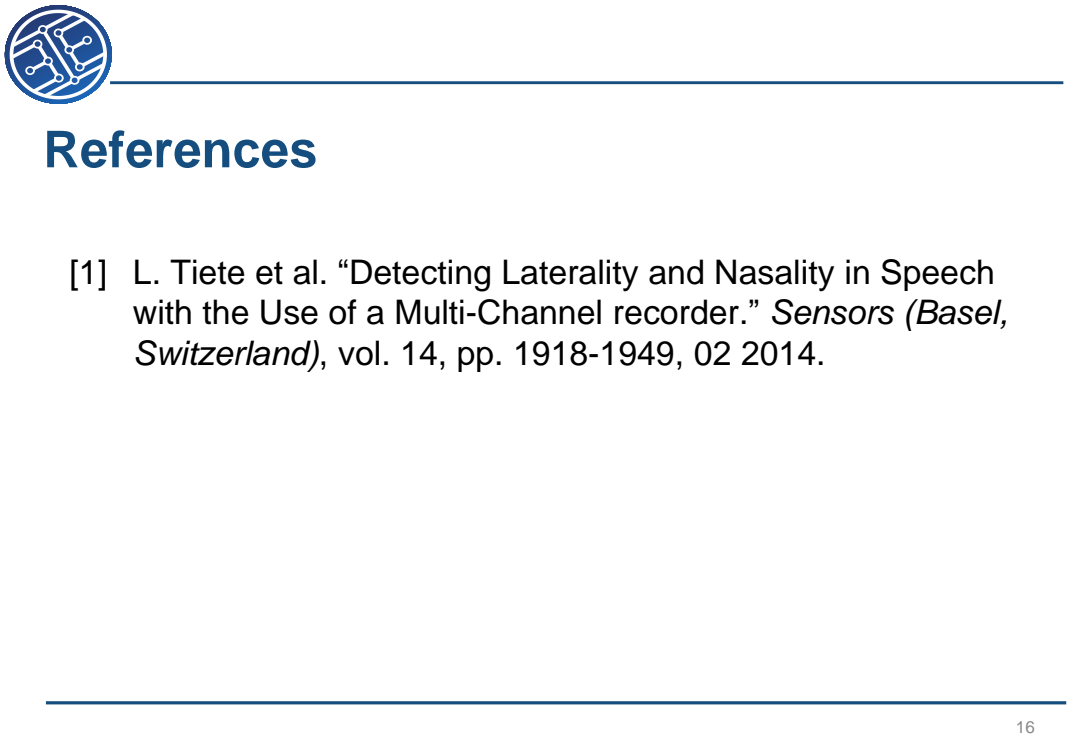
[picture p81: page 16]

[1] L. Tiete et al. “Detecting Laterality and Nasality in Speech
with the Use of a Multi-Channel recorder.” Sensors (Basel,
Switzerland), vol. 14, pp. 1918-1949, 02 2014.

## Questions?

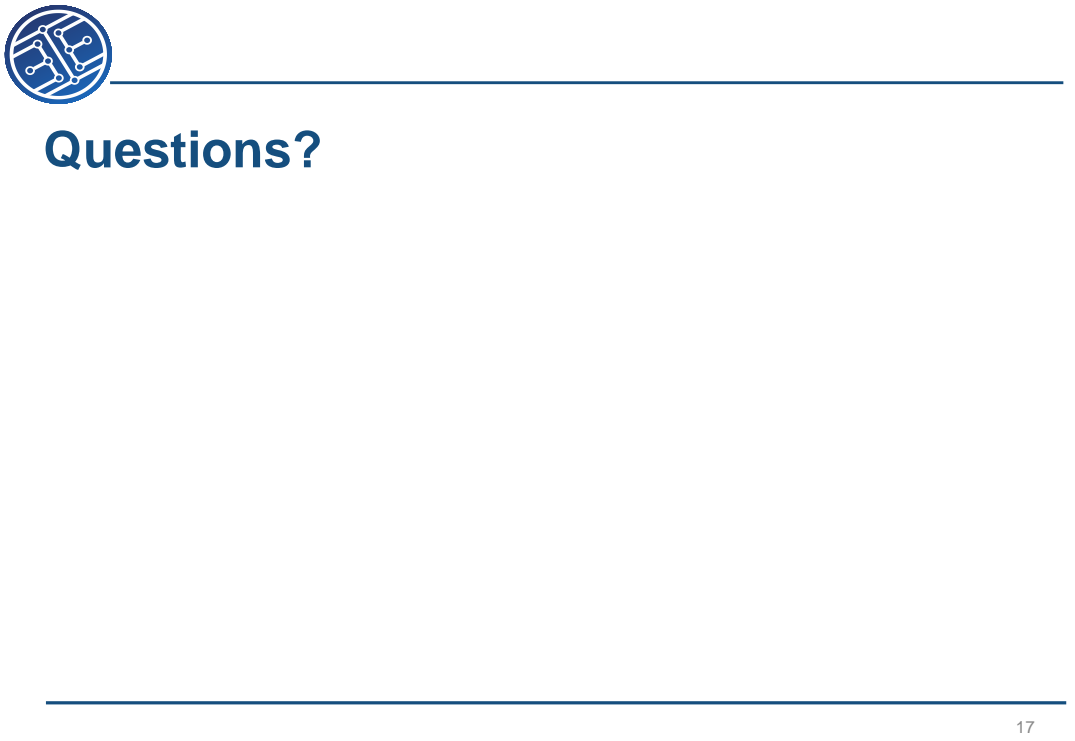
[picture p82: page 17]
