kayjayB/I_cant_hear_you/Presentation/DirectionalityShifts.pdf

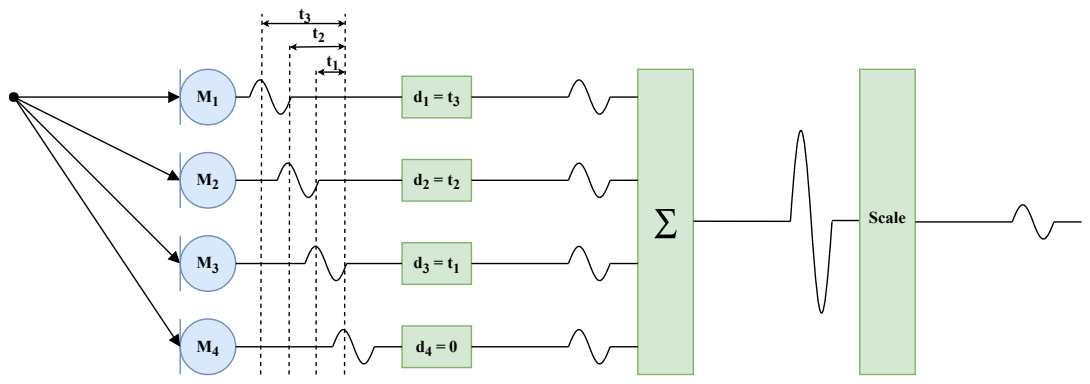
[picture p83: page 1]
Scale
