kayjayB/I_cant_hear_you/Presentation/DirectionalityNoShifts.pdf

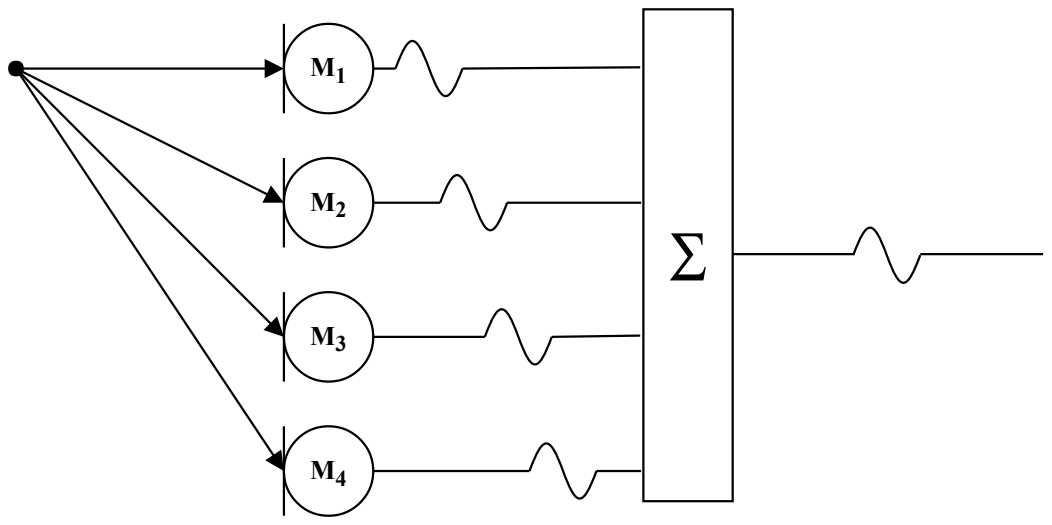
[picture p84: page 1]
