kayjayB/I_cant_hear_you/(commit log)

2018-07-13 First two filters + how to use them. *** Filters do not work properly!!!
2018-07-13 All the filters
2018-07-15 Arduino code: Analog read in Analog output not clear
2018-07-16 The arduino + MATLAB code from imaging
2018-07-17 Microphone->Arduino->earphones working better
2018-07-21 Functions for filtering
2018-07-21 Some useless arduino/matlab code
2018-07-21 New filters with the loop to use them
2018-07-21 Added new filter bank to the GUI Something to look at: the GUI seems to be very slow. It adds lags to the audio signal
2018-07-23 Play button restarts the audio when the audio file is finished
2018-07-24 Directionality with filters
2018-07-26 Changed function definition of filter creation
2018-07-26 End of the day tireds
2018-08-01 Arduino directionality working (we think)
2018-08-02 Currently used library + delete old files
2018-08-03 Arduino code with directionality
2018-08-06 Working Arduino Code
2018-08-07 Much faster ADC
2018-08-07 Arduino code sampling relatively quickly (but not fast enough :( )
2018-08-07 Arduino code with interrupts - working!
2018-08-08 Code with interrupt timing
2018-08-10 Code with timer interrupts
2018-08-10 Backup of timer code before refactor
2018-08-14 DAC and ADC working! yay!
2018-08-14 New zip file and arduino code
2018-08-14 Created a timer setup function
2018-08-14 Initialized the vector where the ADC results are stored
2018-08-14 Created calibration function
2018-08-17 Directionality with many angles. NB: when testing use f=3340Hz
2018-08-22 Final arduino code!
2018-08-23 Final arduino code for reals
2018-08-26 Final Arduino Code
2018-08-30 Filter bank images + script to make the images
2018-08-31 analog filter bank responses with no white space
2018-08-31 added code to get responses of post DAC filters
2018-08-31 circuit diagrams
2018-08-31 Image of device
2018-09-02 Arduino code
2019-09-18 Renamed powerpoint
